dsun7c4/ntpserver-kicad/README.md

# kicad submodule of [ntpserver](https://github.com/dsun7c4/ntpserver)
