dsun7c4/ntpserver-kicad/clock/clock.csv

Reference | Value | Datasheet | Footprint | Qty | DNP | Current | Dielectric | Frequency | Manufacturer | PartNum | Power | Tolerance | Voltage
A201 | CX210_Cover |  | Local:CX210_Cover | 1 |  |  |  |  | Custom | PN
A401 | Microzed |  | Local:Microzed_RevF | 1 |  |  |  |  | Avnet | AES-Z7MB-7Z010-G
BT601 | CR2032 |  | Local:Battery_Holder_2032_BK-5058 | 1 |  |  |  |  | Memory Protection Devices | BK-5058 |  |  | 3.0V
C201,C202,C203,C204,C205,C208,C213,C214,C216,C219,C303,C401,C507,C508,C509,C510,C511,C512,C601,C602,C603 | 0.1uF |  | Local:C_0805_HandSoldering | 21 |  |  | X7R |  | Kemet | C0805C104K5RACTU |  | 10% | 50V
C206,C207,C217 | 0.1uF |  | Local:C_0805_HandSoldering | 3 | DNP |  | X7R |  | Kemet | C0805C104K5RACTU |  | 10% | 50V
C209 | 22uF |  | Local:C_1206_3216Metric_Pad2.00x1.60mm_HandSolder | 1 | DNP |  | X5R |  | TDK | C3216X5R1A226M160AC |  | 20% | 10V
C210 | 470pF |  | Local:C_0805_HandSoldering | 1 |  |  | C0G |  | Kemet | C0805C471J5GACTU |  | 5% | 50V
C211 | 10pF |  | Local:C_0805_HandSoldering | 1 |  |  | C0G |  | Kemet | C0805C100J5GACTU |  | 5% | 50V
C212,C519,C520,C521,C522,C523,C524 | 22uF |  | Local:C_1206_3216Metric_Pad2.00x1.60mm_HandSolder | 7 |  |  | X5R |  | TDK | C3216X5R1A226M160AC |  | 20% | 10V
C215,C218,C301,C302,C501,C502,C503,C504,C505,C506 | 10uF |  | Local:C_1206_3216Metric_Pad2.00x1.60mm_HandSolder | 10 |  |  | X5R |  | TDK | C3216X5R1E106K160AB |  | 10% | 25V
C402,C516,C517,C518 | 47pF |  | Local:C_0805_HandSoldering | 4 |  |  | C0G |  | Kemet | C0805C470J5GACTU |  | 5% | 50V
C513,C514,C515 | 0.47uF |  | Local:C_0805_HandSoldering | 3 |  |  | X7R |  | Kemet | C0805C474K5RACTU |  | 10% | 50V
D201,D301,D501,D502 | GREEN |  | Local:LED_0805_HandSoldering | 4 |  |  |  |  | Lite-On | LIST-C171GKT
D401 | MM3Z3V3T1G |  | Local:SOD-323_477-02-H_HandSoldering | 1 |  |  |  |  | ON Semiconductor | MM3Z3V3T1G | 300mW |  | 3.3V
FB201,FB301 | 60@100MHz | ~ | Local:R_0805_2012Metric_Pad1.50x1.30mm_HandSolder | 2 |  | 3A |  |  | Pulse Electronics | PE-0805PFB600ST |  | 25%
HS201 | TO220_heatsink |  | Local:Heatsink_581x | 1 |  |  |  |  | Aavid | 581002B02500G
JP501,JP502 | Jumper_NO_Small |  | Connector_PinHeader_2.54mm:PinHeader_1x02_P2.54mm_Vertical | 2
L501 | 3.3uH |  | Local:Choke_SMD_7.1x6.5_H3.0_HandSoldering | 1 |  | 6.2A |  |  | TDK | SPM6530T-3R3M
L502,L503 | 2.2uH |  | Local:Choke_SMD_7.1x6.5_H3.0_HandSoldering | 2 |  | 8.4A |  |  | TDK | SPM6530T-2R2M
P101 | CONN_01X03 |  | Local:Terminal_Block_1x03 | 1 |  |  |  |  | Phoenix Contact | 1729131
P102 | CONN_FAN_PWM |  | Local:470531000 | 1 |  |  |  |  | Molex | 47053-1000
P103 | XG4A-1631 |  | Local:XG4A-1631 | 1 |  |  |  |  | Omron Electronics | XG4A-1631
P301 | MCRF |  | Local:MCRF_73412 | 1 |  |  |  |  | Molex | 073412-0110
P401 | CONN_01X10 |  | Connector_PinHeader_2.54mm:PinHeader_1x10_P2.54mm_Horizontal | 1 | DNP
PX1,PX2 | 61083_02X50 |  | Local:61083-2X50-SMD_HandSoldering | 2 |  |  |  |  | FCI | 61083-101400LF
Q201 | MMBT3904 |  | Local:SOT-23-3_NXP_HandSoldering | 1 |  |  |  |  | NXP Semiconductors | MMBT3904
Q301,Q302,Q401,Q402 | BSS138 |  | Local:SOT-23-3_NXP_HandSoldering | 4 | DNP |  |  |  | ON Semiconductor | BSS138LT1G
Q501,Q502 | BSS138 |  | Local:SOT-23-3_NXP_HandSoldering | 2 |  |  |  |  | ON Semiconductor | BSS138LT1G
R201,R202,R206,R207,R211,R219,R302,R305,R406,R517,R518,R601,R602,R603,R604,R605,R606,R607,R608,R609,R610,R611,R612 | 1.00K |  | Local:R_0805_HandSoldering | 23 |  |  |  |  | Vishay Dale | CRCW08051K00FKEA | 0.125W | 1%
R203,R204,R213,R215,R216,R217,R301,R303,R401,R407,R410,R504,R505,R506,R516 | 10.0K |  | Local:R_0805_HandSoldering | 15 |  |  |  |  | Vishay Dale | CRCW080510K0FKEA | 0.125W | 1%
R205,R501,R502,R503,R513 | 100K |  | Local:R_0805_HandSoldering | 5 |  |  |  |  | Vishay Dale | CRCW0805100KFKEA | 0.125W | 1%
R208,R209,R210 | 49.9K |  | Local:R_0805_HandSoldering | 3 |  |  |  |  | Vishay Dale | CRCW080549K9FKEA | 0.125W | 1%
R212 | 0.1R |  | Local:CSM2512_0R007_0R2 | 1 |  |  |  |  | Vishay Foil | Y14870R10000B9R | 1W | 0.1%
R214,R218 | 36.5R |  | Local:R_0805_HandSoldering | 2 |  |  |  |  | Vishay Dale | CRCW080536R5FKEA | 0.125W | 1%
R304,R408 | 10.0K |  | Local:R_0805_HandSoldering | 2 | DNP |  |  |  | Vishay Dale | CRCW080510K0FKEA | 0.125W | 1%
R402,R403,R404,R405,R409,R411 | 0R |  | Local:R_0805_HandSoldering | 6 |  |  |  |  | Vishay Dale | CRCW08050000Z0EA | 0.125W | 1%
R507 | 36.5K |  | Local:R_0805_HandSoldering | 1 |  |  |  |  | Vishay Dale | CRCW080536K5FKEA | 0.125W | 1%
R508,R510,R512 | 4.99K |  | Local:R_0805_HandSoldering | 3 |  |  |  |  | Vishay Dale | CRCW08054K99FKEA | 0.125W | 1%
R509 | 22.6K |  | Local:R_0805_HandSoldering | 1 |  |  |  |  | Vishay Dale | CRCW080522K6FKEA | 0.125W | 1%
R511 | 20.0K |  | Local:R_0805_HandSoldering | 1 |  |  |  |  | Vishay Dale | CRCW080520K0FKEA | 0.125W | 1%
R514,R515 | 100K |  | Local:R_0805_HandSoldering | 2 | DNP |  |  |  | Vishay Dale | CRCW0805100KFKEA | 0.125W | 1%
U201 | PCA9306 |  | Package_SO:MSOP-8_3x3mm_P0.65mm | 1 |  |  |  |  | Texas Instruments | PCA9306DCTR
U202 | DAC8830 |  | Package_SO:SOIC-8_3.9x4.9mm_P1.27mm | 1 |  |  |  |  | Texas Instruments | DAC8830ICD |  | ± 1 LSB
U203 | LMV722 |  | Package_SO:SOIC-8_3.9x4.9mm_P1.27mm | 1 |  |  |  |  | Texas Instruments | LMV722MX/NOPB
U204 | LTC2990 |  | Package_SO:MSOP-10_3x3mm_P0.5mm | 1 |  |  |  |  | Linear Technology | LTC2990CMS#PBF
U205 | LP3853 |  | Local:TO220-5-Vertical_NDH | 1 |  | 3A |  |  | Texas Instruments | LP3853ET-3.3/NOPB |  |  | 3.3V
U207 | NC7SZ125 |  | Local:SOT-23-5_1.6x2.9mm_Pitch0.95mm_HandSoldering | 1 |  |  |  |  | Fairchild Semiconductor | NC7SZ125M5X
U301 | Adafruit746 |  | Local:Adafruit746 | 1 | DNP |  |  |  | Adafruit | Adafruit746
U302 | MIC5225 |  | Local:SOT-23-5_1.6x2.9mm_Pitch0.95mm_HandSoldering | 1 |  | 0.15A |  |  | Micrel | MIC5225-3.3YM5-TR |  |  | 3.3V
U303 | PA6H |  | Local:FGPMMOPA6H | 1 |  |  |  |  | GlobalTop Technology | PA6H
U401 | 74LVC541 |  | Package_SO:TSSOP-20_4.4x6.5mm_P0.65mm | 1 |  |  |  |  | Texas Instruments | SN74LVC541APWR
U501,U502,U503 | TPS56428 |  | Local:SOIC-8_PowerPAD_HandSoldering | 3 |  |  |  |  | Texas Instruments | TPS56428DDA
U601,U603 | ADT7410 |  | Package_SO:SOIC-8_3.9x4.9mm_P1.27mm | 2 |  |  |  |  | Analog Devices | ADT7410TRZ
U602 | DS3231 |  | Local:SOIC-16_Maxim_W16_H2 | 1 |  |  |  |  | Maxim Integrated | DS3231S#
Y202 | CX210 |  | Local:CX210_HandSoldering | 1 |  |  |  | 10.0MHz | Connor Winfield | OH300-50503CV-010.0M
