dsun7c4/ntpserver-kicad/2x7seg/disp.csv

Reference | Value | Datasheet | Footprint | Qty | DNP | Current | Dielectric | Frequency | Manufacturer | PartNum | Power | Tolerance | Voltage
C1,C3 | 10uF |  | Local:C_1206_HandSoldering | 2 |  |  | X5R |  | TDK | C3216X5R1E106K160AB |  | 10% | 25V
C2,C4 | 0.1uF |  | Local:C_0805_HandSoldering | 2 |  |  | X7R |  | Kemet | C0805C104K5RACTU |  | 10% | 50V
DS1 | LDD-A814RI |  | Local:LDD-A814RI | 1 |  |  |  |  | Lumex | LDD-A814RI
P1,P2 | CONN_01X08 |  | Local:Pin_Header_1x08_edge | 2
R1 | 5.11K |  | Local:R_0805_HandSoldering | 1 |  |  |  |  | Vishay Dale | CRCW08055K11FKEA | 0.125W | 1%
U1 | TLC59282_REV |  | Local:SSOP-24_3.9x8.65mm_Pitch0.635mm | 1 |  |  |  |  | Texas Instruments | TLC59282DBQ
