dsun7c4/ntpserver-kicad/8x16seg/8x16seg.csv

Reference | Value | Datasheet | Footprint | Qty | DNP | Dielectric | Manufacturer | PartNum | Power | Tolerance | Voltage | Current | Frequency
C1,C10,C11,C20 | 10uF |  | Local:C_1206_HandSoldering | 4 |  | X5R | TDK | C3216X5R1E106K160AB |  | 10% | 25V
C2,C3,C4,C5,C6,C7,C8,C9,C12,C13,C14,C15,C16,C17,C18,C19 | 0.1uF |  | Local:C_0805_HandSoldering | 16 |  | X7R | Kemet | C0805C104K5RACTU |  | 10% | 50V
DS1,DS2,DS3,DS4,DS5,DS6,DS7,DS8 | PSA08-11SRWA |  | Local:PSA08-11SRWA | 8 |  |  | Kingbright | PSA08-11SRWA
P1,P2 | CONN_01X08 |  | Connector_PinSocket_2.54mm:PinSocket_1x08_P2.54mm_Vertical | 2
R1,R2,R3,R4,R5,R6,R7,R8,R9 | 5.11K |  | Local:R_0805_HandSoldering | 9 |  |  | Vishay Dale | CRCW08055K11FKEA | 0.125W | 1%
U1,U2,U3,U4,U5,U6,U7,U8,U9 | TLC59282_REV |  | Local:SSOP-24_3.9x8.65mm_Pitch0.635mm | 9 |  |  | Texas Instruments | TLC59282DBQ
