dsun7c4/ntpserver-kicad/rj45brkout/rj45brkout.csv

Reference | Value | Datasheet | Footprint | Qty | DNP | Manufacturer | PartNum | Voltage | Tolerance | Dielectric | Power | Current | Frequency
J101 | RJ45_LEDS |  | Local:rj45-8-pm | 1 |  | Amphenol | MRJ5381M1
P101,P102,P103,P104,P105,P106,P107,P108,P109,P110,P111,P112 | CONN_01X01 |  | Local:wire_50x30mil | 12
