dsun7c4/ntpserver-kicad/8x16seg/8x16seg.pdf

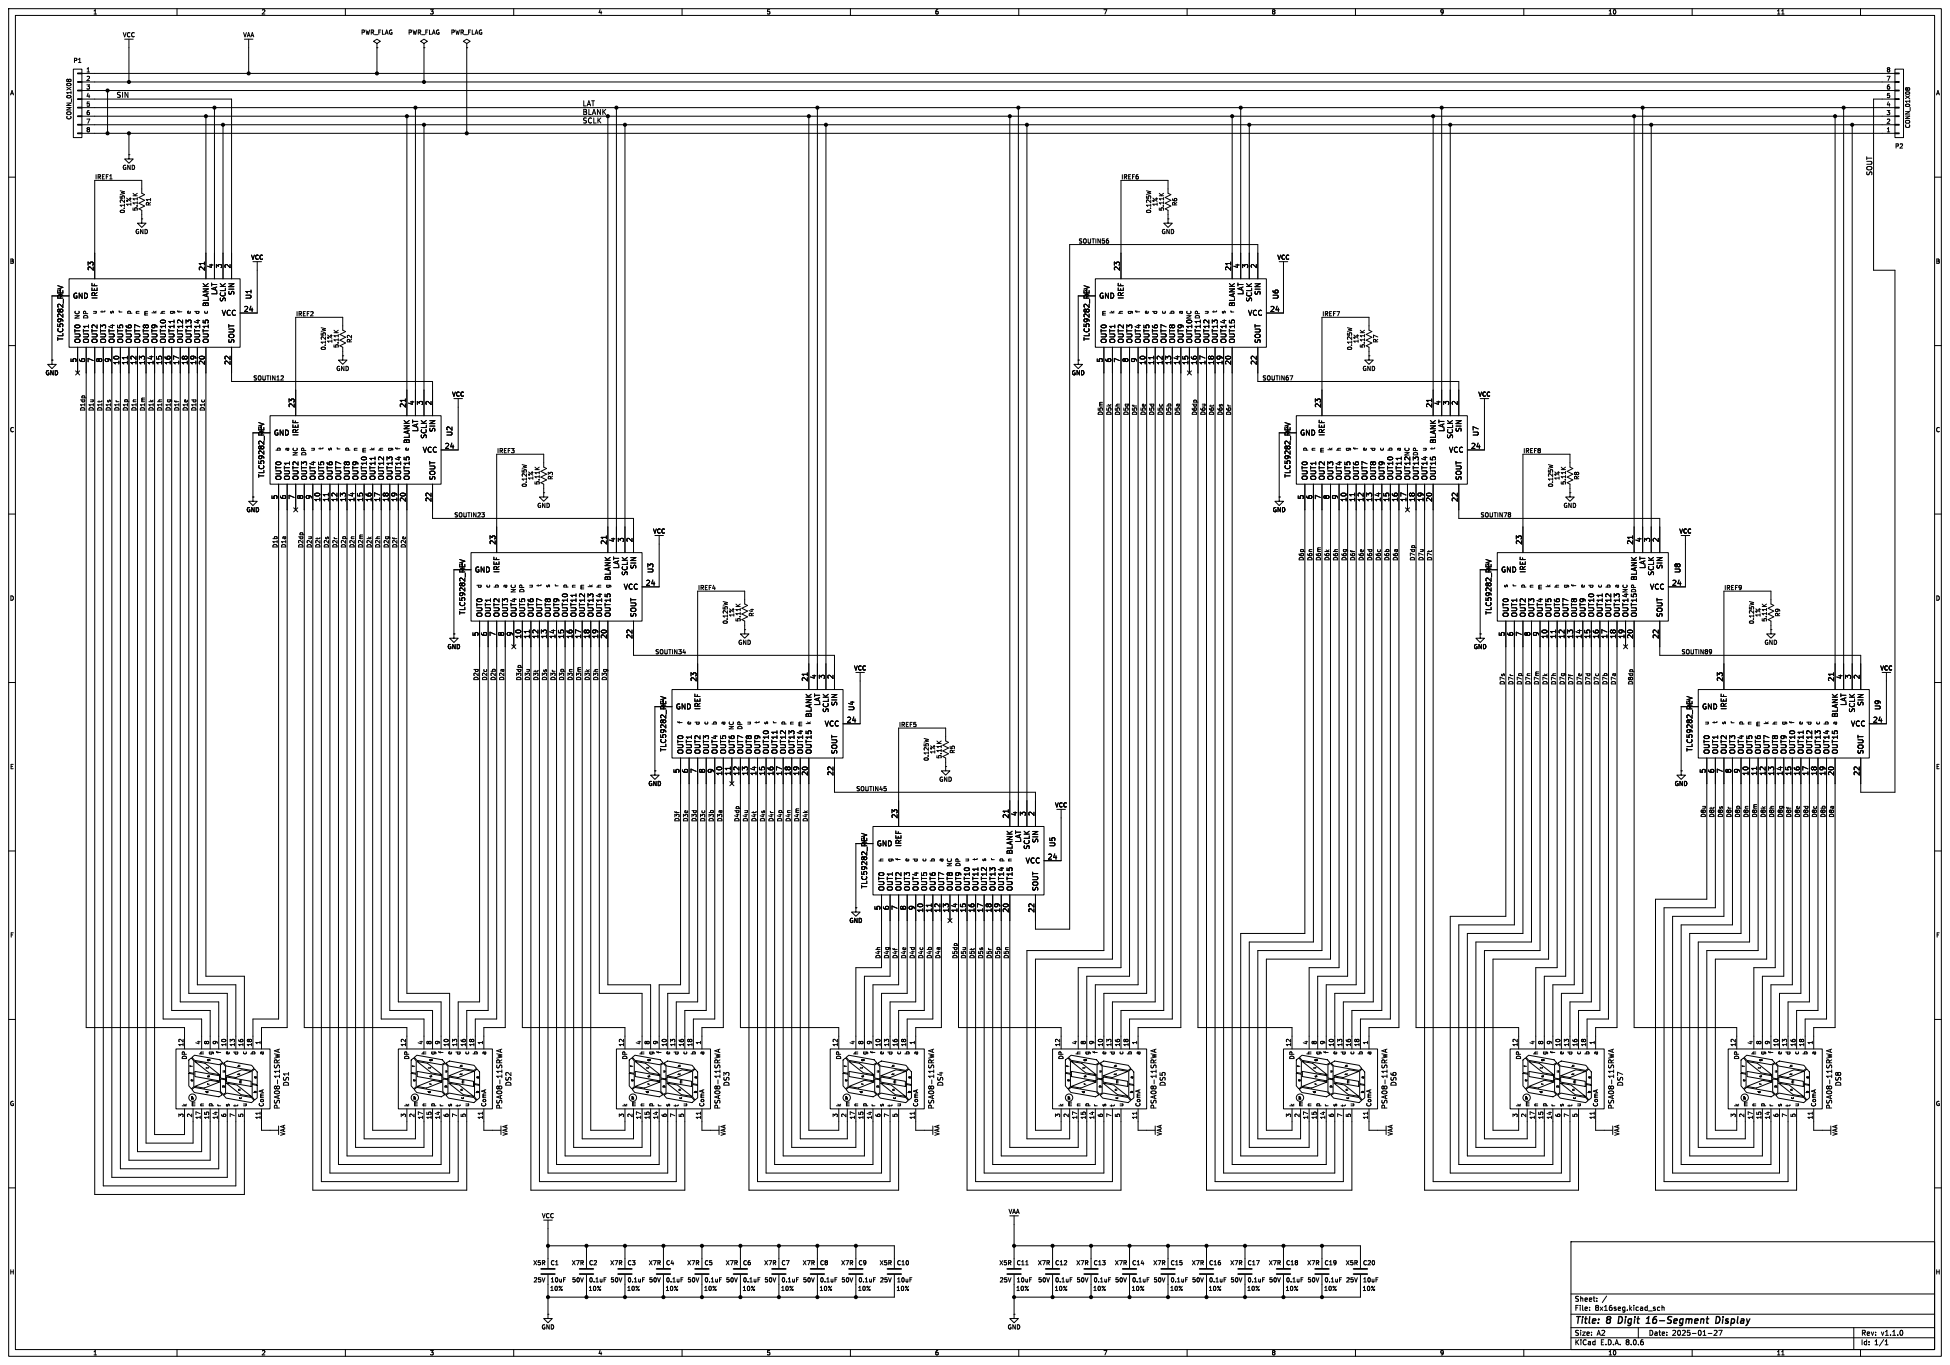
[picture p1: page 1]

2 OUT15 20 BLANK 21 SOUT 22 IREF 23 SCLK

r GND GND GND U4 TLC59282_REVGND 1 VCC 24 OUT5 10 OUT6 11 OUT7 12 OUT8 13 OUT9 14 OUT10 15 OUT11 16 OUT12 17 OUT13 18 OUT14 19 SIN
