dsun7c4/ntpserver-kicad/clock/clock.pdf

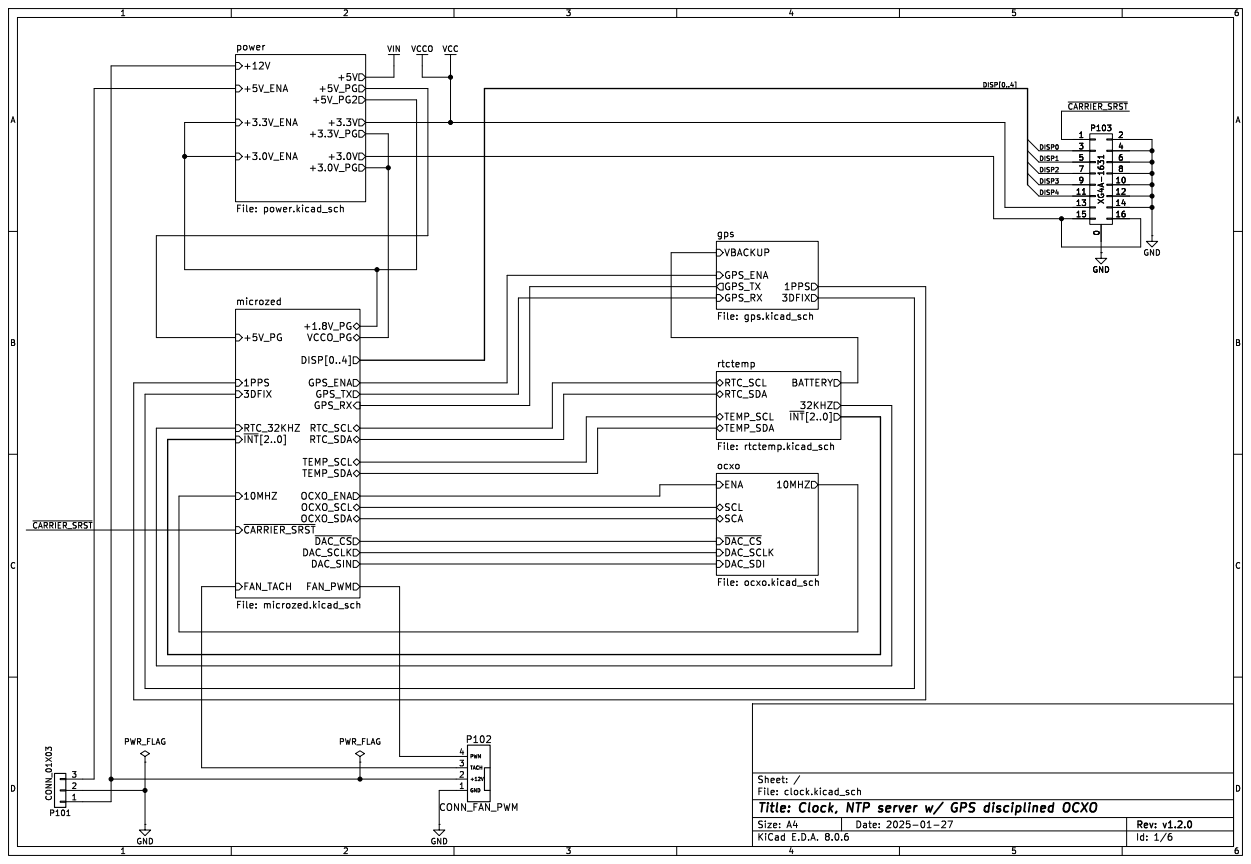
[picture p2: page 1]

~{INT}[2..0] microzed File: microzed.kicad_sch

gps File: gps.kicad_sch
VBACKUP
File: clock.kicad_sch Sheet: / 10MHZ SCL

Id: 1/6 Title: Clock, NTP server w/ GPS disciplined OCXO

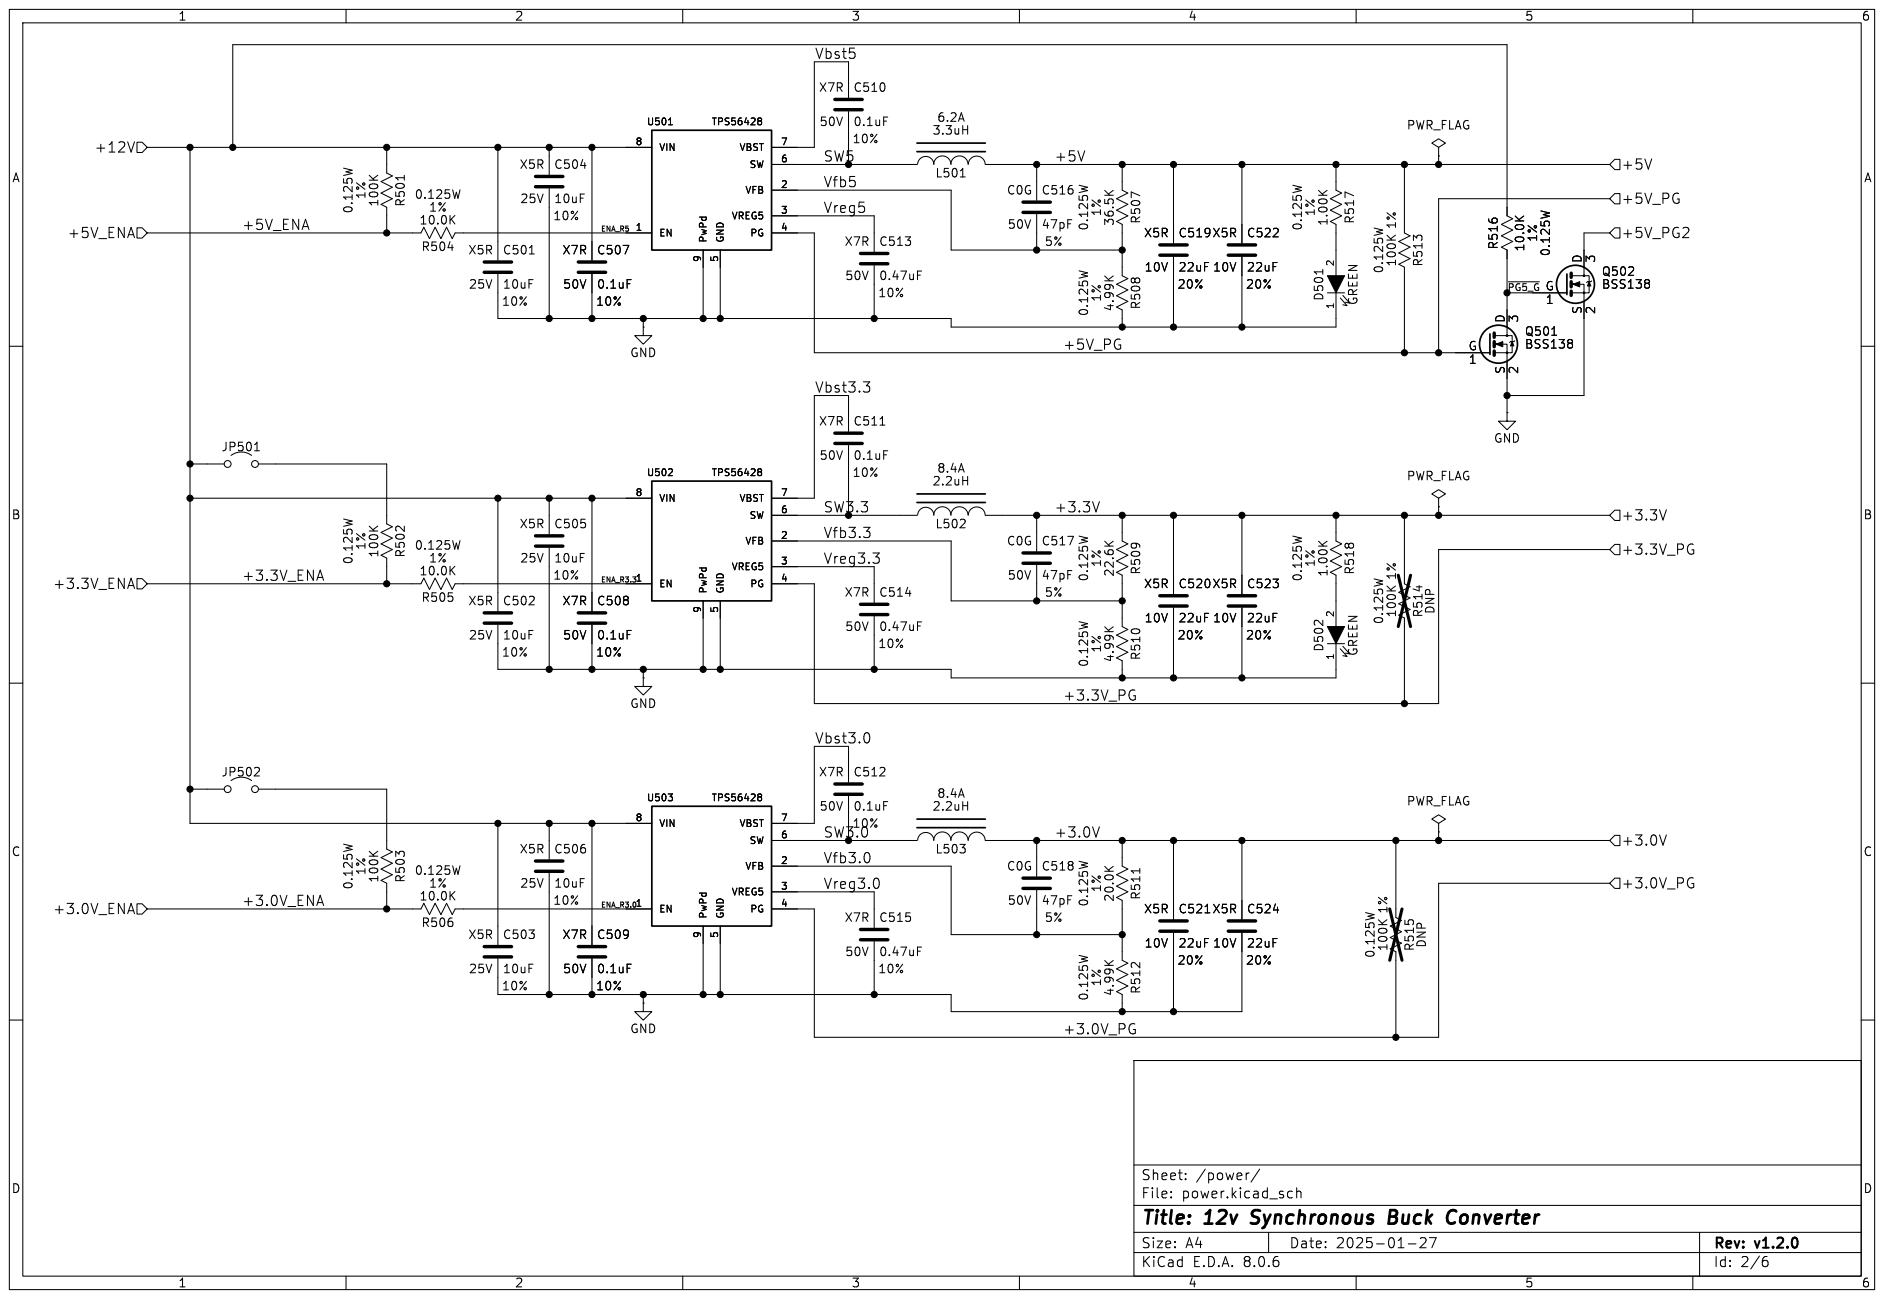
[picture p3: page 2]

5 SW 6 VBST 7 VIN 8 PwPd

9 U502 TPS56428 EN 1 VFB 2 VREG5 3 PG 4 GND

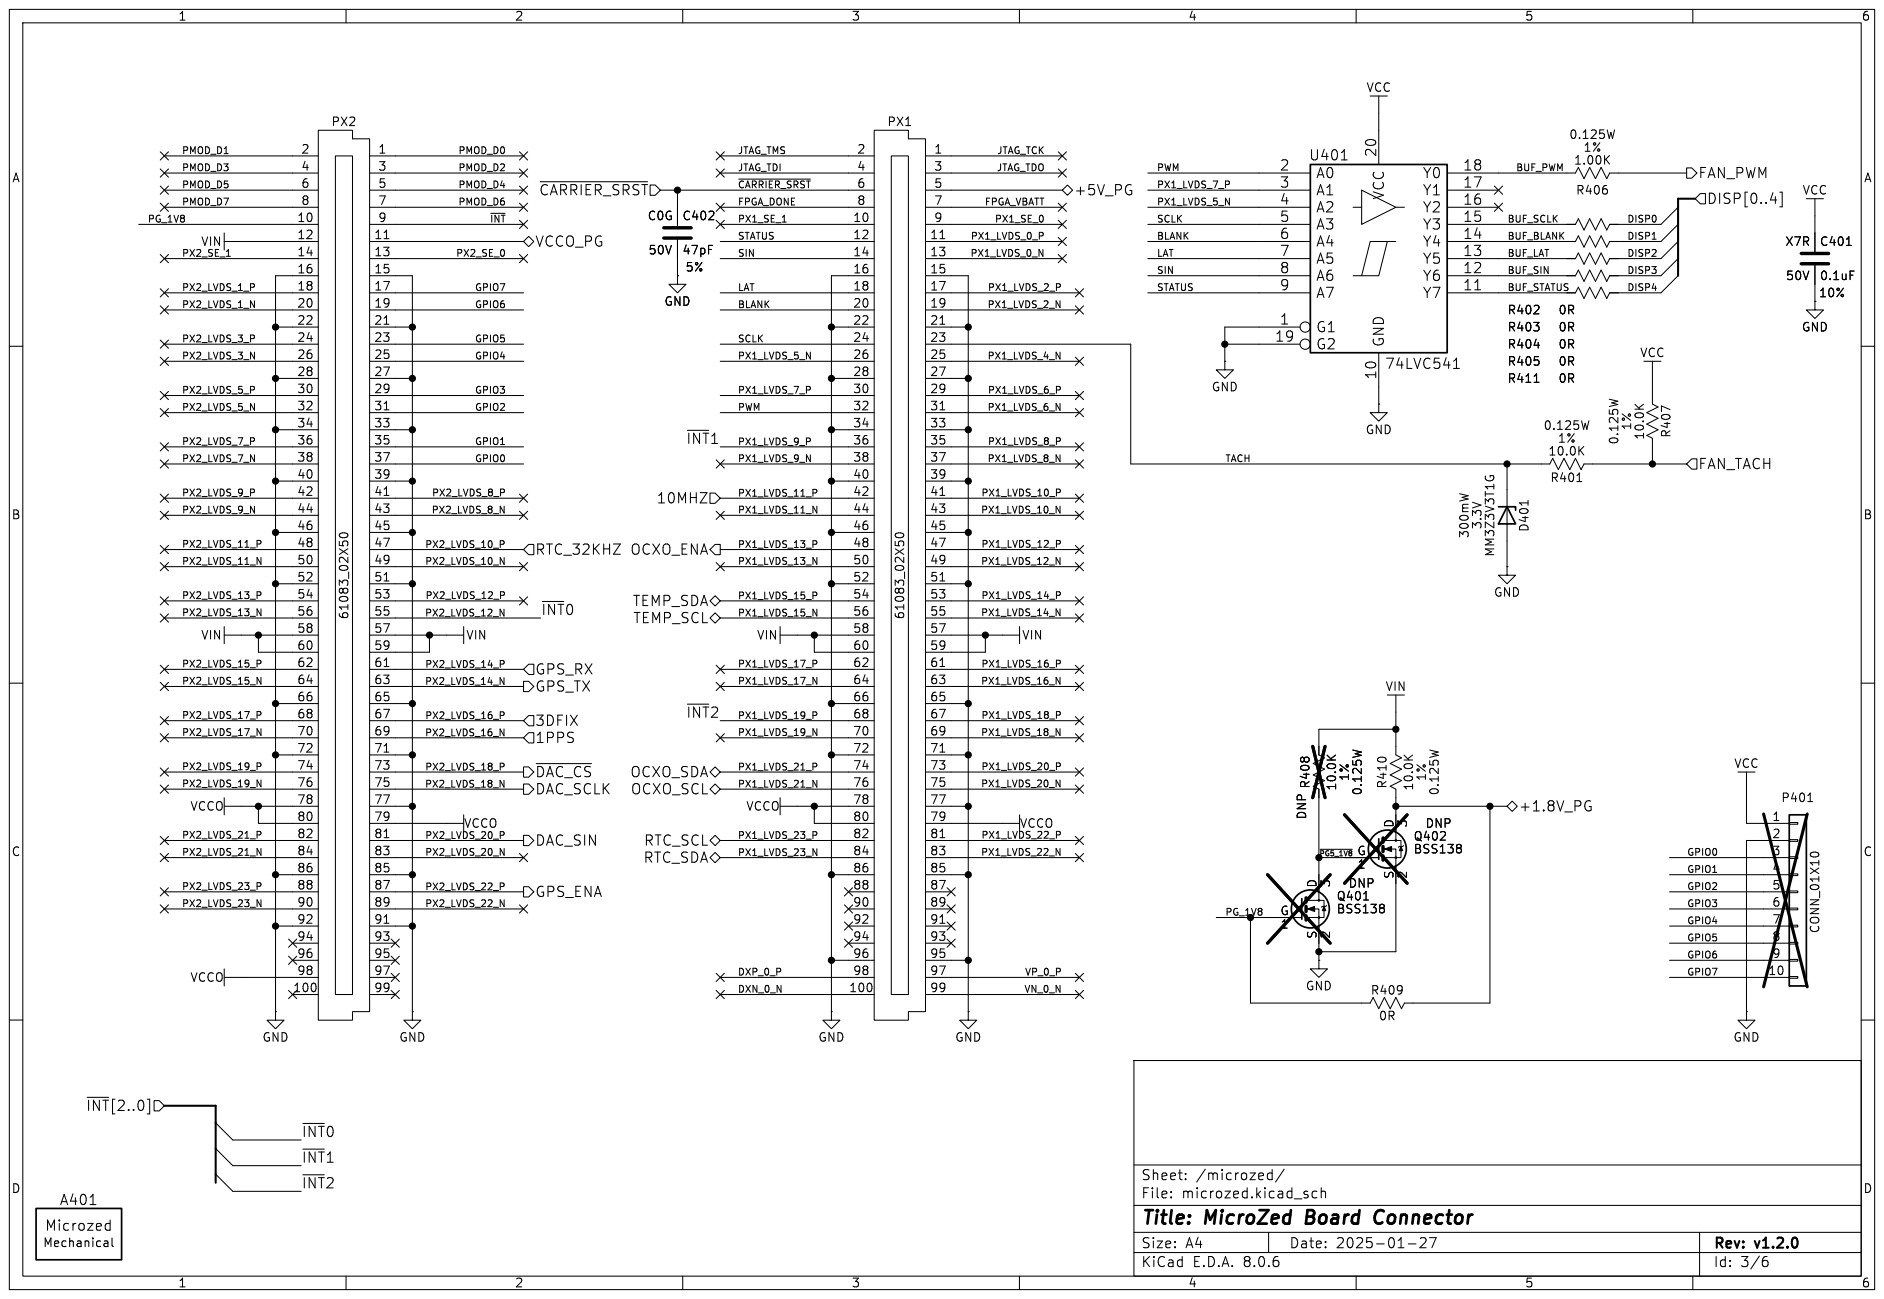
[picture p4: page 3]

Id: 3/6 Title: MicroZed Board Connector File: microzed.kicad_sch Sheet: /microzed/ VCCO

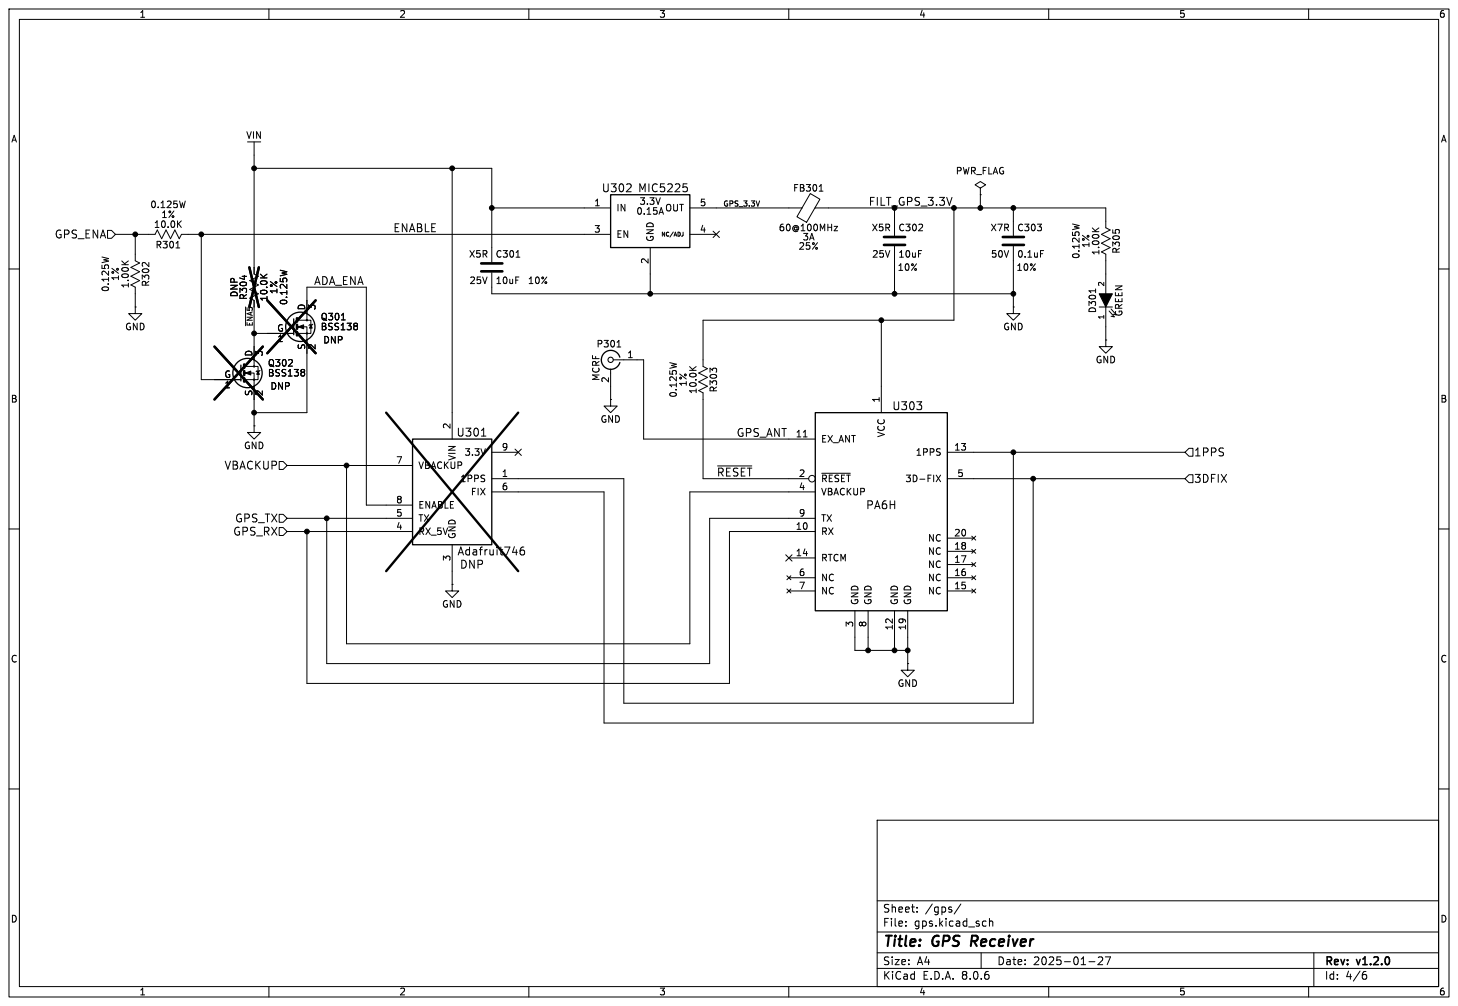
[picture p5: page 4]

3 RX_5V 4 TX 5 FIX 6 VBACKUP 7 ENABLE 8

Id: 4/6 Title: GPS Receiver File: gps.kicad_sch Sheet: /gps/

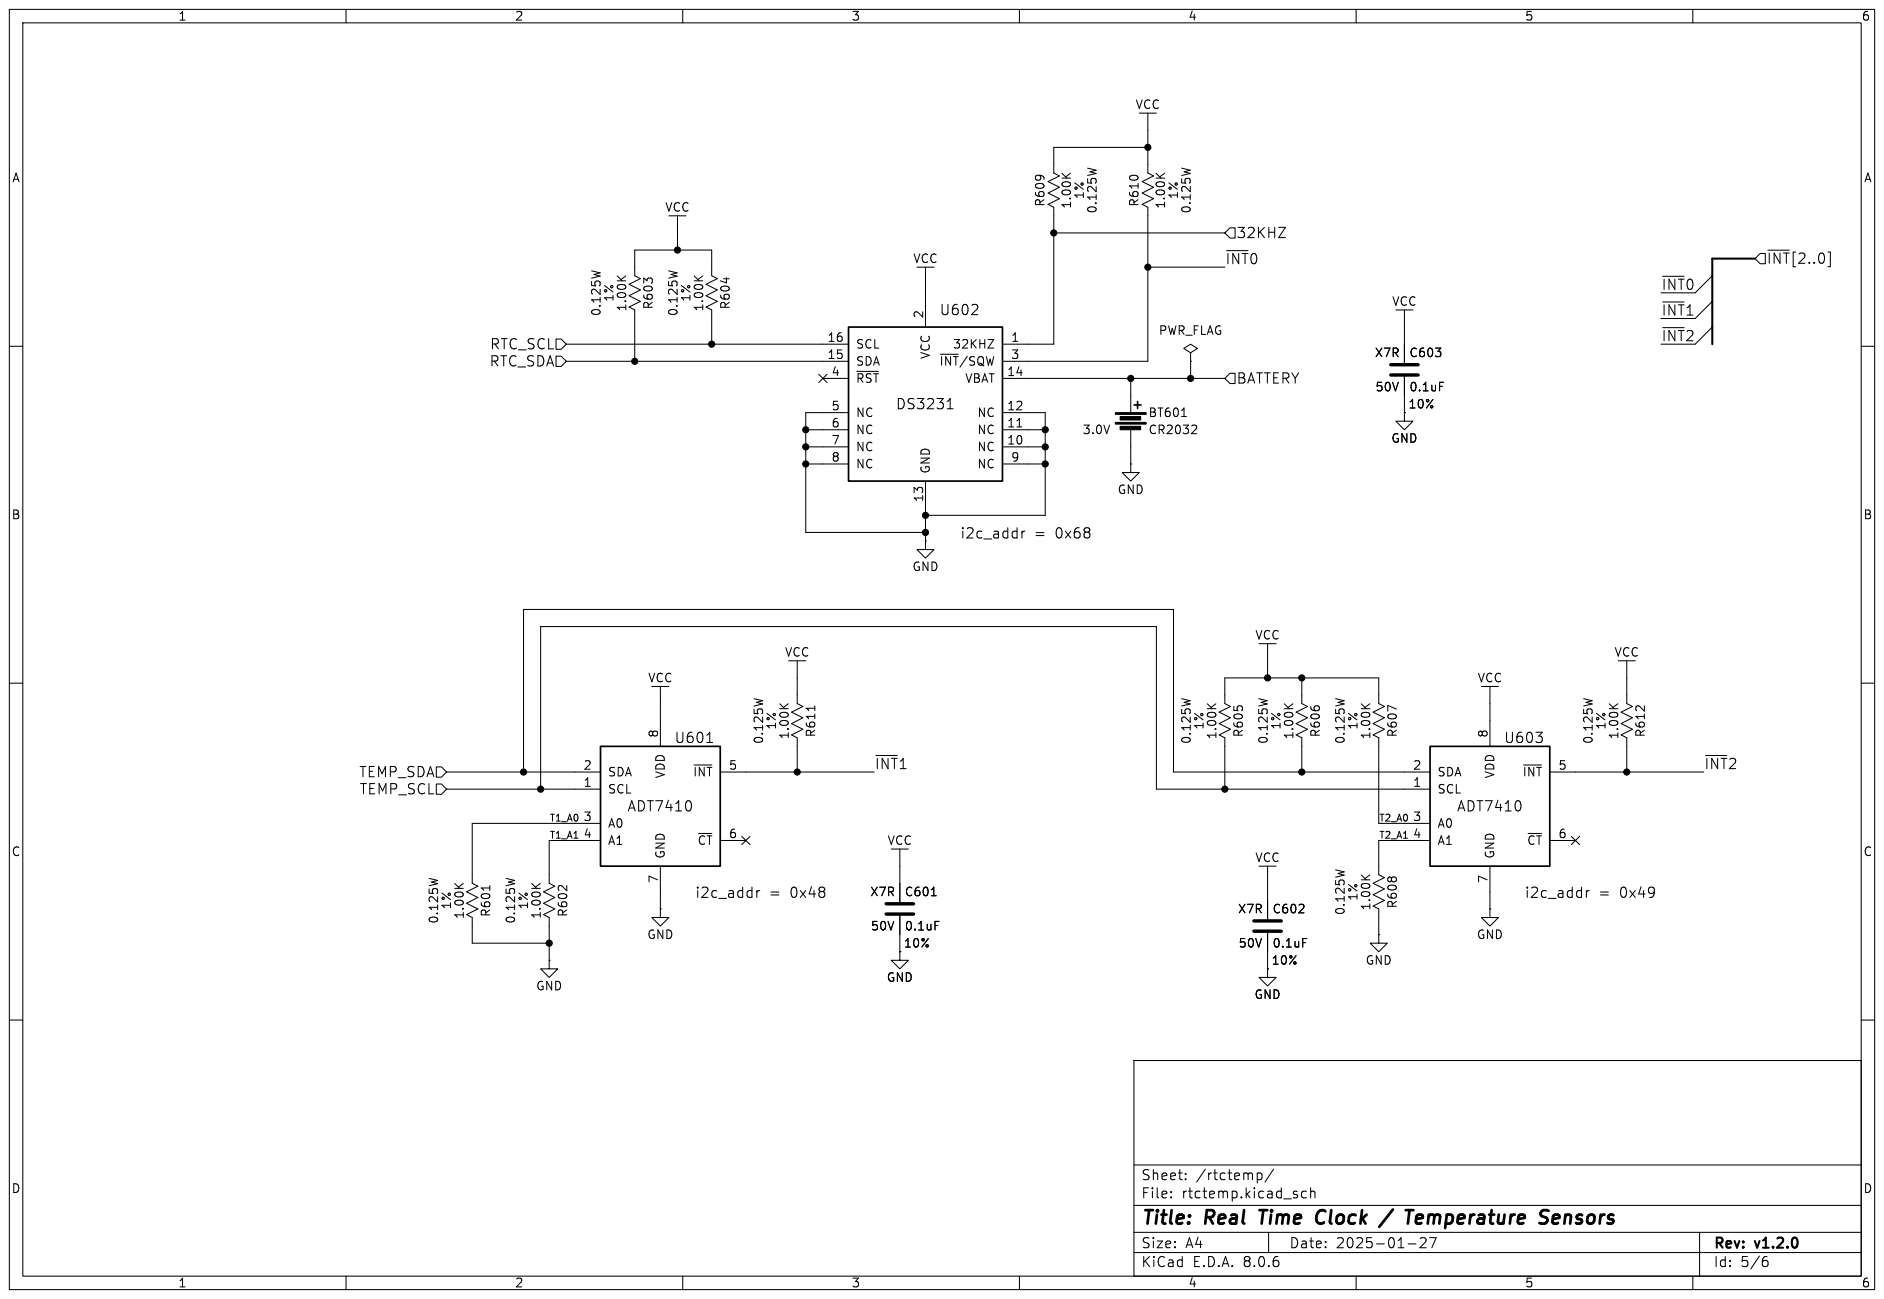
[picture p6: page 5]

2 ~{INT}/SQW 3 ~{RST} 4 NC 5 NC 6 NC 7 NC 8 NC 9 U602 DS3231

File: rtctemp.kicad_sch Sheet: /rtctemp/
Id: 5/6 Title: Real Time Clock / Temperature Sensors

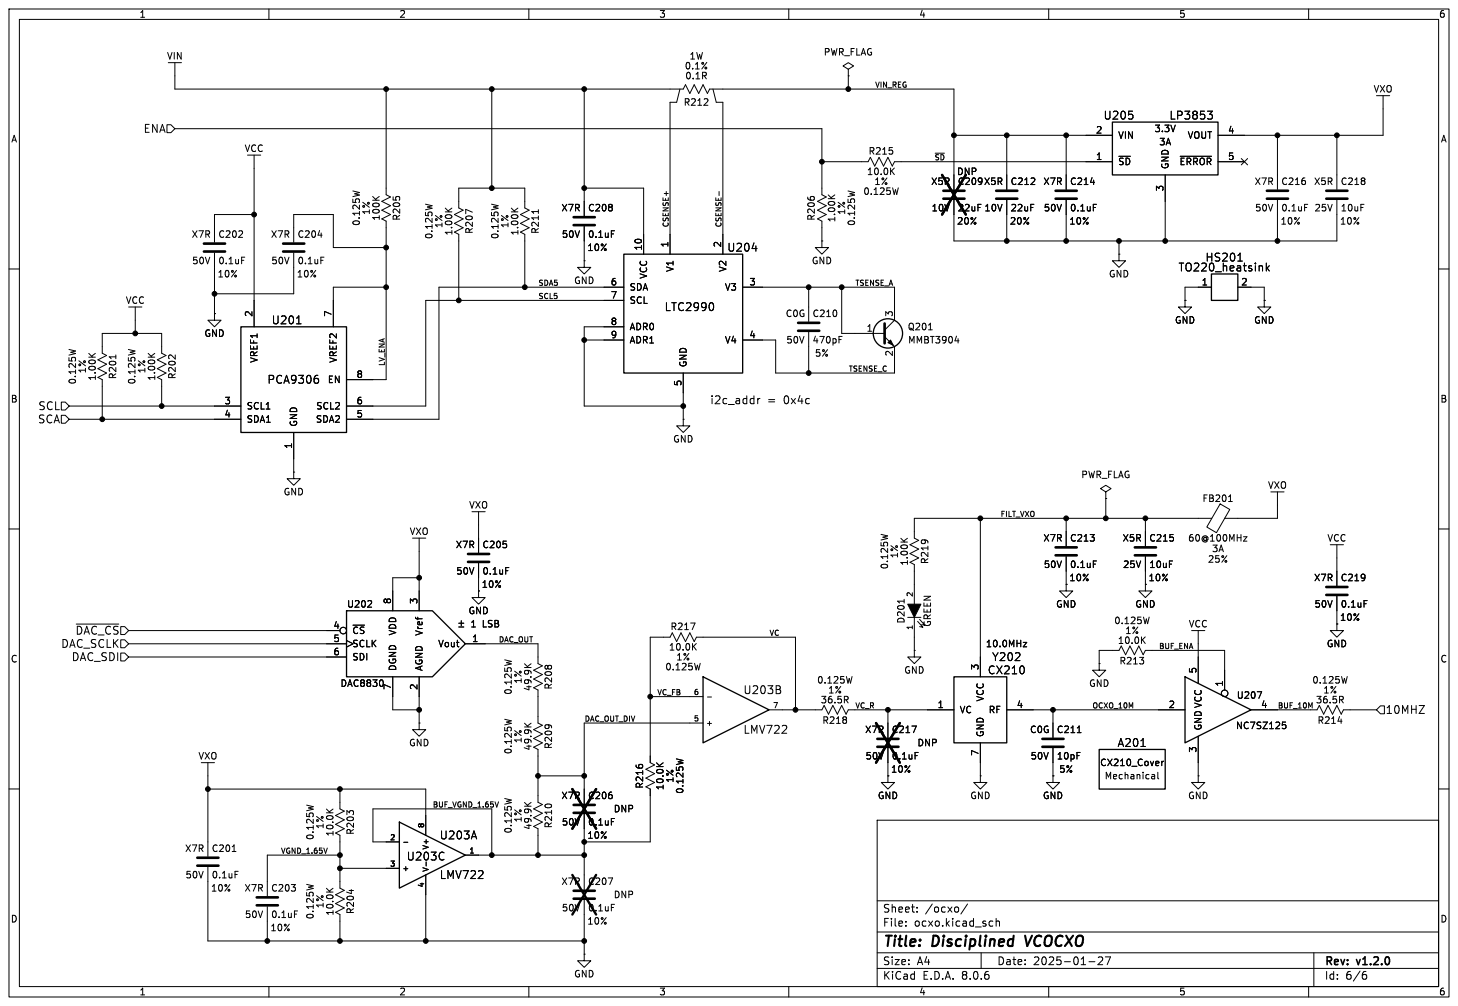
[picture p7: page 6]

2 Vref 3 ~{CS} 4 SCLK 5 SDI 6 DGND

Id: 6/6 Title: Disciplined VCOCXO
