dsun7c4/ntpserver-kicad/rj45brkout/rj45brkout.pdf

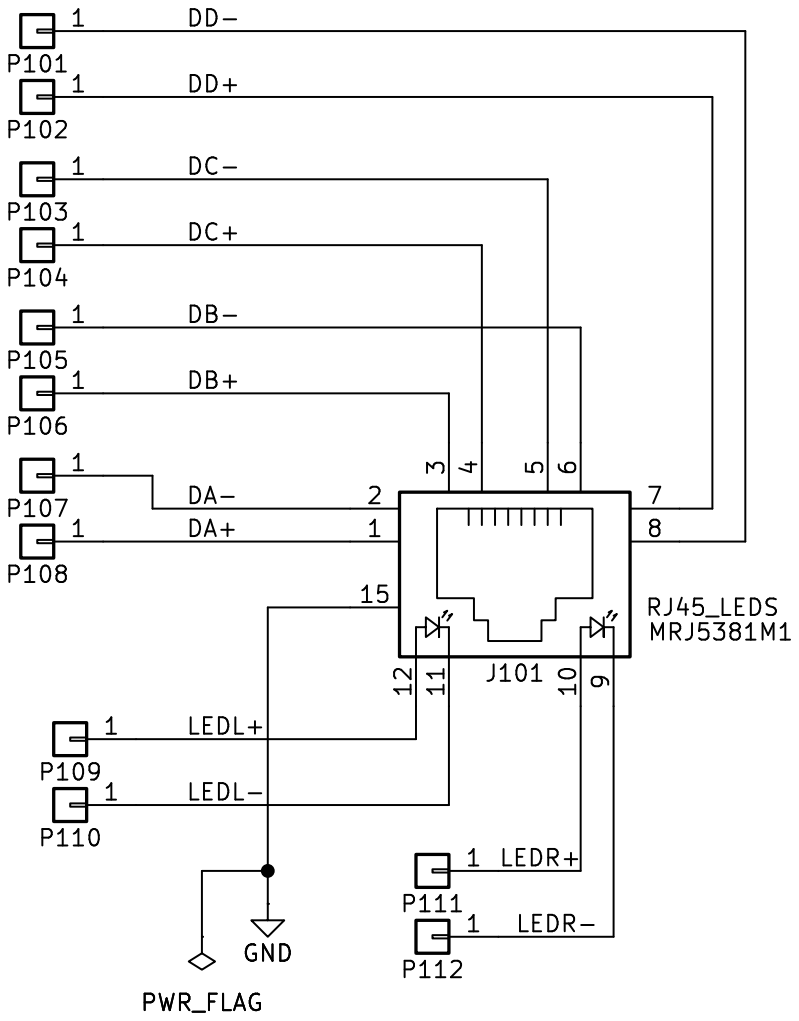
[picture p8: page 1]

LEDL- DB- DA+ DA- DD+ DD- DC- GND

Id: 1/1 Title: rj45 panel mount breakout File: rj45brkout.kicad_sch Sheet: /
