dsun7c4/ntpserver-kicad/term/term.pdf

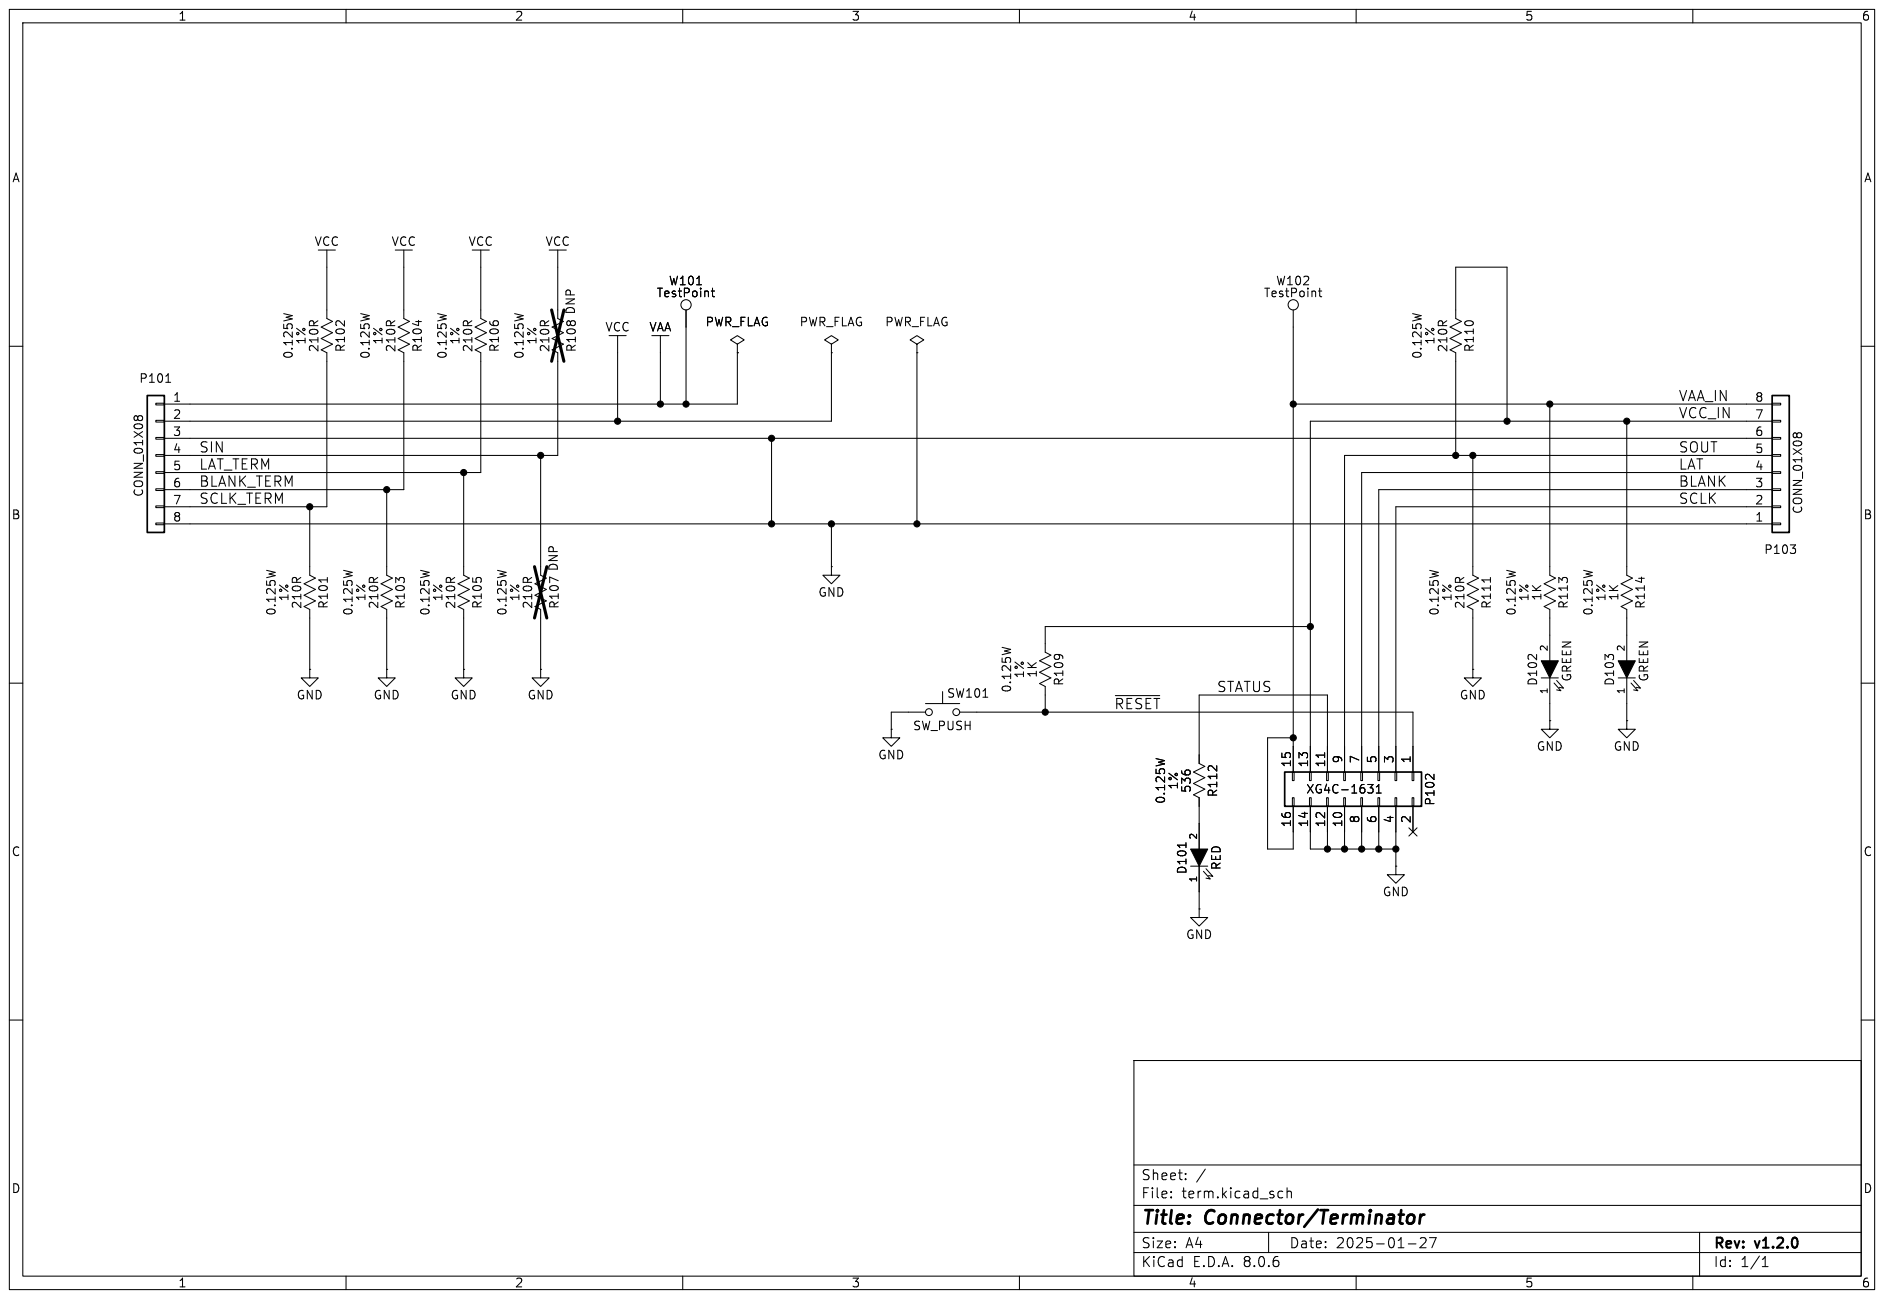
[picture p9: page 1]

1 2 D101 RED GND GND GND GND 210R R103 1% 0.125W

Id: 1/1 Title: Connector/Terminator File: term.kicad_sch Sheet: /
