dsun7c4/ntpserver-kicad/usbabrkout/usbabrkout.pdf

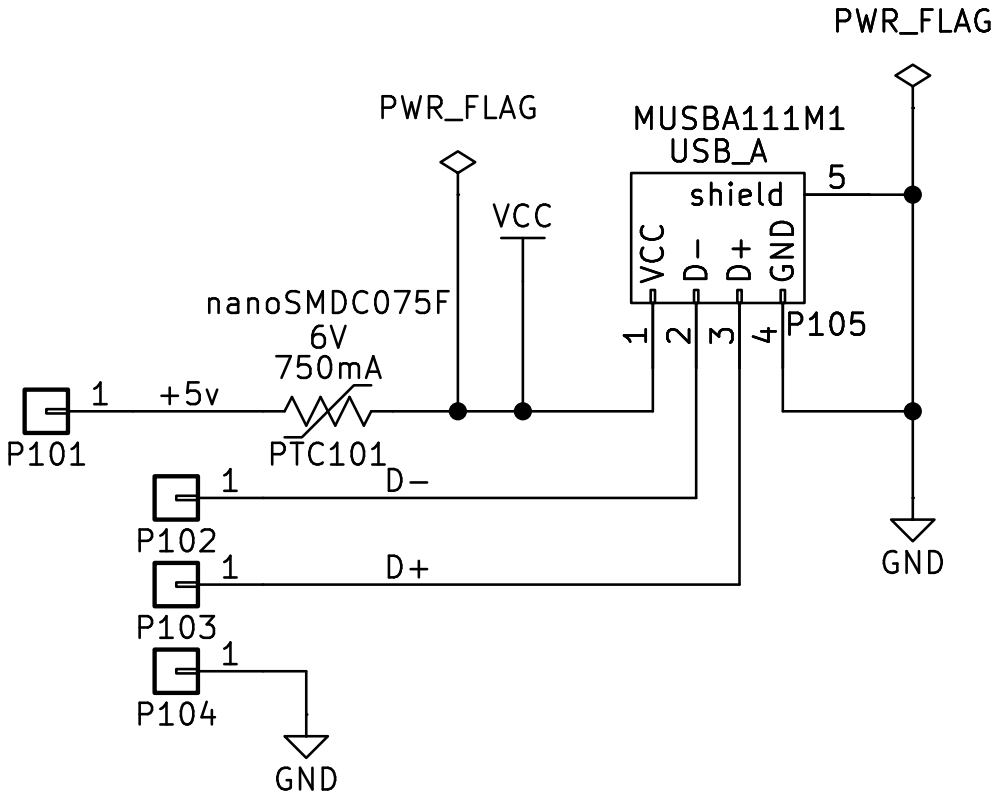
[picture p10: page 1]

3 GND
Id: 1/1 Title: USB-A panel mount breakout File: usbabrkout.kicad_sch Sheet: / VCC
