dsun7c4/ntpserver-kicad/usbbbrkout/usbbbrkout.pdf

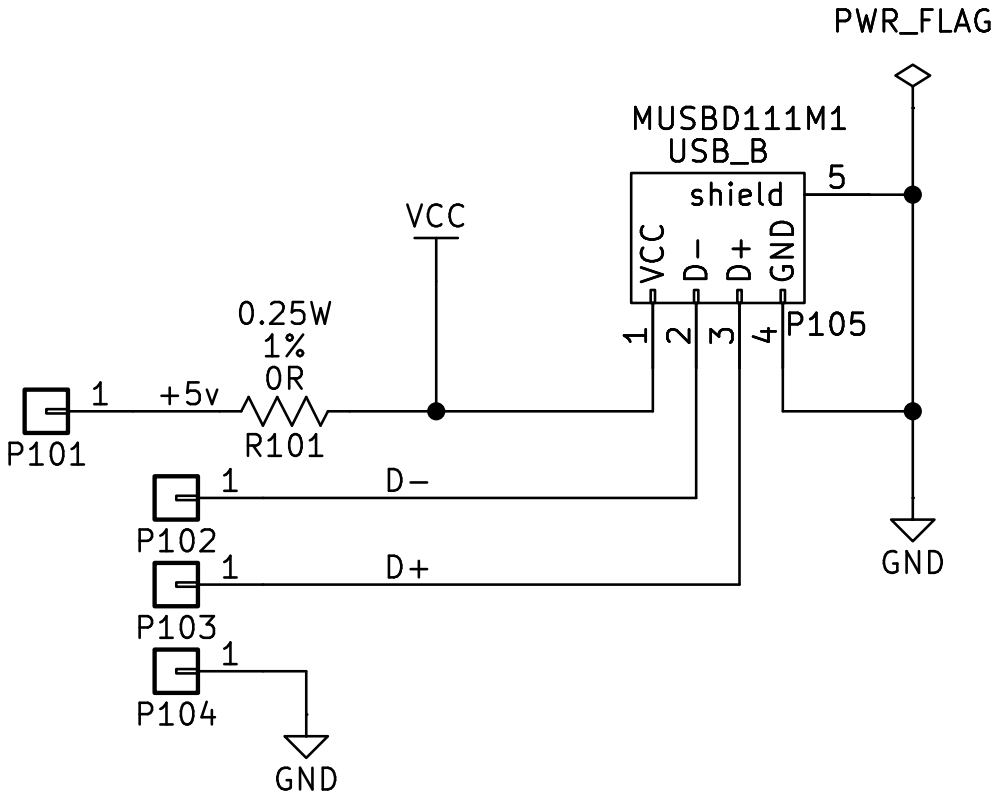
[picture p11: page 1]

Id: 1/1 Title: USB-B panel mount breakout File: usbbbrkout.kicad_sch Sheet: / R101
