dsun7c4/ntpserver-kicad/2x7seg/disp.pdf

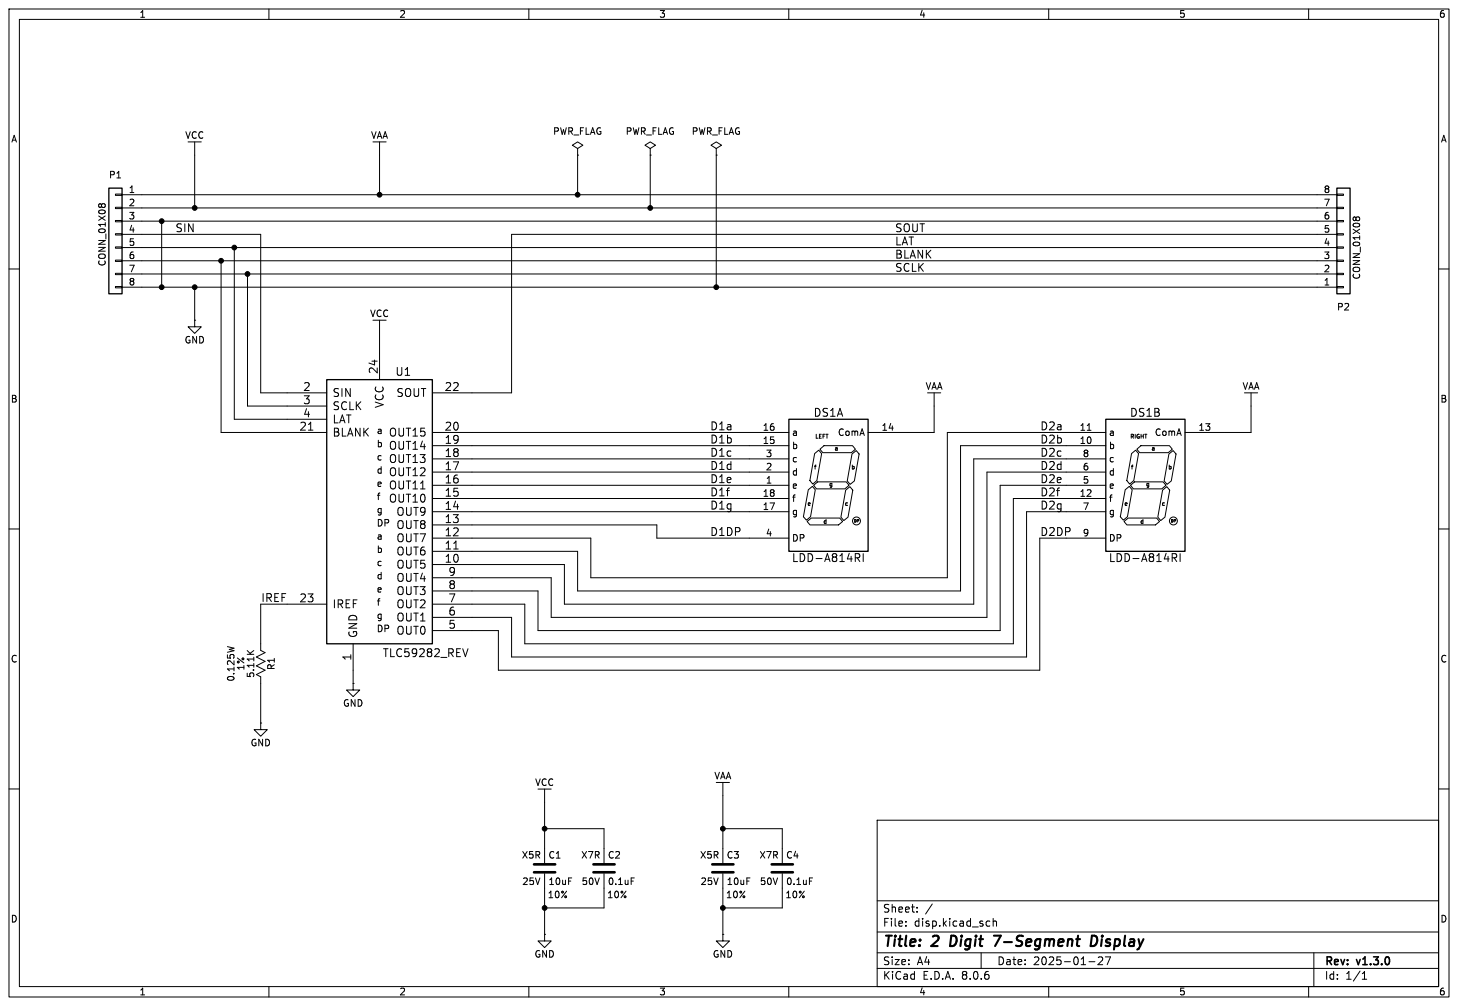
[picture p12: page 1]
