dsun7c4/ntpserver-kicad/(commit log)

2014-12-15 Add kicad local libraries
2014-12-16 Turn off some 3D models Check in gerber files Ordered...
2015-06-20 Checkpoint DCDC converter evaluation board.
2015-06-22 Fix up thermal via footprint to work with OSHPark.
2015-06-24 Fix pad position for inductor (1mm too wide). Regenerate gerbers. Upload to OSHPark.
2015-06-24 Add connector for microzed board.
2015-06-25 Add mounting hole using NPTH pad type.
2015-06-26 Add footprint for Lumex 7-segment display. Add footprint for LED current driver chip, SOIC-24.
2015-06-26 Minor local library footprint cleanup.
2015-06-29 Clean up 7-segment footprint drawing.
2015-06-30 Correct segment vertex point calculations. Regenerate footprint.
2015-07-04 Add 7-segment schematic symbol and TLC59282 driver chip.
2015-07-05 Fix pin type for TLC59282 pin 18 (OUT13). Set scale to 0.5 for 3d model of 25mil pitch SOIC24.
2015-07-05 Start 2 digit 7-segment display board.
    [disp.kicad_pcb, disp.sch]
2015-07-05 Adjust the pin drill size for the 7-seg display.
    [disp.kicad_pcb, disp.sch]
2015-07-07 Optimize some of the ground fill.
    [disp.kicad_pcb]
2015-07-08 Add pin header with edge connect footprint.
2015-07-10 Fix minimum annular ring. Use 10mil minimum clearance.
    [disp.kicad_pcb]
2015-07-12 Increase spacing between power tracks. Add gerber files.
    [disp-B_Cu.gbr, disp-B_Mask.gbr, disp-B_SilkS.gbr, disp-Edge_Cuts.gbr, disp-F_Cu.gbr, disp-F_Mask.gbr, disp-F_SilkS.gbr, disp.drl]
2015-07-17 Increase annular ring around vias.
    [disp-B_Cu.gbr, disp-B_Mask.gbr, disp-B_SilkS.gbr, disp-Edge_Cuts.gbr, disp-F_Cu.gbr, disp-F_Mask.gbr, disp-F_SilkS.gbr, disp.drl]
2015-07-18 Adjust the silk screen a little. Move some vias out of back silkscreen. Stitch in some more ground fill. Upload to OSHPark.
    [disp-B_Cu.gbr, disp-B_Mask.gbr, disp-B_SilkS.gbr, disp-Edge_Cuts.gbr, disp-F_Cu.gbr, disp-F_Mask.gbr, disp-F_SilkS.gbr, disp.drl]
2015-08-03 Use 1% resistor values
    [disp.sch]
2015-08-10 Checkpoint schematic symbol for 2x50 connector.
2015-08-16 Move some vias away from silkscreen.
    [disp-B_Cu.gbr, disp-B_Mask.gbr, disp-B_SilkS.gbr, disp-Edge_Cuts.gbr, disp-F_Cu.gbr, disp-F_Mask.gbr, disp-F_SilkS.gbr, disp.drl]
2015-09-21 Remove silk from through hole pads.
2015-09-25 Update gerber and upload to OSHPark.
    [disp-B_Cu.gbr, disp-B_Mask.gbr, disp-B_SilkS.gbr, disp-Edge_Cuts.gbr, disp-F_Cu.gbr, disp-F_Mask.gbr, disp-F_SilkS.gbr, disp.drl]
2015-10-01 Add Ad5662, ADT7410, DS3231, LTC2990, NE5532, Resistor, and cx210 schematic symbols.
2015-10-06 Add GPS receiver, VCXO, LP3853, MIC5225 and PCA9306 schematic symbols.
2015-10-17 Add footprint for CX210 and adafruit GPS module. Add DAC8830 and LVM722. Increase hole size for LDD-A814RI.
2015-10-18 Add footprint for VCXO, GTop GPS module.
2015-10-20 Initial schematic for NTP server.
    [clock.sch, gps.sch, microzed.sch, ocxo.sch, power.sch]
2015-10-20 Add power symbols.
2015-10-28 Add more BOM parameters to local parts.
2015-10-28 Fill in some of the BOM entries.
    [clock.sch, gps.sch, ocxo.sch, power.sch]
2015-10-29 Add current sense resistors.
2015-10-29 Update parts with parameter detail and BOM information.
    [gps.sch, microzed.sch, ocxo.sch, power.sch]
2015-10-30 Add heatsink and RF coax connector footprint.
2015-10-30 Add parameter for RF connector. Start adding display connections.
    [clock.sch, gps.sch, ocxo.sch, power.sch]
2015-11-01 Add schematic symbol for TO-220 heatsink. Add TO-220 footprint. Add Microzed mechanical footprint.
2015-11-01 Add sheet for RTC and temperature sensors.
    [clock.sch, gps.sch, microzed.sch, ocxo.sch, power.sch, rtctemp.sch]
2015-11-02 Add some markers in the Microzed mechanical footprint. Add single gate buffer.
2015-11-02 Add proper loading and buffer to the OCXO output.
    [clock.sch, ocxo.sch, rtctemp.sch]
2015-11-07 Add PWM fan connector.
2015-11-07 Fan and power connectors.
    [clock.sch, microzed.sch, ocxo.sch, power.sch, rtctemp.sch]
2015-11-07 Add footprint for Maxim RTC.
2015-11-08 Add SOT-23-5 footprint. Add more detail to microzed mechanical footprint.
2015-11-08 Correct footprint selection. Start pcb. Add BOM files.
    [clock.csv, clock.kicad_pcb, clock.sch, gps.sch, microzed.sch, ocxo.sch, power.sch, rtctemp.sch]
2015-11-08 Make component parameters consistent for BOM.
    [clock.csv, clock.kicad_pcb, gps.sch, ocxo.sch, power.sch, rtctemp.sch]
2015-11-09 Add net names to most of the nets.
    [clock.csv, clock.kicad_pcb, gps.sch, microzed.sch, ocxo.sch, power.sch, rtctemp.sch]
2015-11-10 Add filter for OCXO power.
    [clock.csv, clock.kicad_pcb, gps.sch, microzed.sch, ocxo.sch, power.sch, rtctemp.sch]
2015-11-12 Add OCXO cover mechanical footprint. Add CR2032 battery holder.
2015-11-12 Clean up most of the schematic DRC errors. Update placement.
    [clock.csv, clock.kicad_pcb, gps.sch, microzed.sch, ocxo.sch, power.sch, rtctemp.sch]
2015-11-14 Checkpoint PCB placement.
    [clock.csv, clock.kicad_pcb, clock.sch, ocxo.sch, power.sch, rtctemp.sch]
2015-11-15 Add On semi SOD-323 footprint. Add keepout comments to CX210 cover and adafruit 746 footprints.
2015-11-16 Rename CUS520 footprint.
2015-11-16 Checkpoint PCB.
    [clock.csv, clock.kicad_pcb, clock.sch, microzed.sch]
2015-11-20 Checkpoint... Pin swaps on microzed connector.
    [clock.kicad_pcb, gps.sch, microzed.sch]
2015-11-20 Place the reference designators.
    [clock.kicad_pcb, clock.sch, microzed.sch]
2015-11-22 Add more via stitching on the GND fills. Add gerber files.
    [clock-B_Cu.gbr, clock-B_Mask.gbr, clock-B_SilkS.gbr, clock-Edge_Cuts.gbr, clock-F_Cu.gbr, clock-F_Fab.gbr, clock-F_Mask.gbr, clock-F_SilkS.gbr]
2015-11-22 Add stitching via footprint.
2015-11-25 Correct spelling. Minor clean ups.
    [clock-B_Cu.gbr, clock-B_Mask.gbr, clock-B_SilkS.gbr, clock-Edge_Cuts.gbr, clock-F_Cu.gbr, clock-F_Fab.gbr, clock-F_Mask.gbr, clock-F_SilkS.gbr]
2015-11-26 Add NXP SOT-23 recommended footprint.
2015-11-27 Change SOT-23 footprint. Move some vias onto grid.
    [clock.csv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]
2015-11-27 Add 16 pin 8x2 header connector.
2015-11-28 Move some vias onto grid.
    [clock.kicad_pcb]
2015-11-28 Next version of display board. Increase size of holes for display pins.
    [disp.csv, disp.kicad_pcb, disp.sch]
2015-11-28 Set value to be invisible. Add large stitching via / heatsink vent hole.
2015-11-30 Hide value in stitching via. Reduce width of display board by 10 mils.
    [clock.kicad_pcb, disp.kicad_pcb]
2015-12-10 Add breakout footprint for FVXO to CX210. Add connector symbol to tie mounting holes to ground.
2015-12-10 Lock all the stitching vias. Remove FVXO alternate to OCXO.
    [clock.csv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]
2015-12-15 Rename gerbers for kicad 4.0.
    [clock-B.Cu.gbr, clock-B.Mask.gbr, clock-B.SilkS.gbr, clock-Edge.Cuts.gbr, clock-F.Cu.gbr, clock-F.Mask.gbr, clock-F.SilkS.gbr, clock.drl]
2015-12-20 Fix pad location for to-220-5. Increase hole size slightly for heatsink. Add 3D models.
2015-12-20 3D models for to220-5, cx210, heatsink.
2015-12-21 Fix pin location on to-220 and heatsink location. Add 7-segment display 3D model to board.
    [clock.kicad_pcb, disp.kicad_pcb]
2016-01-07 3D model of clock case and zync heat sink clamp.
2016-01-11 Add inductor and sot-23 3d models.
    [clock.kicad_pcb]
2016-01-11 Add 3d model of PWM fan connector.
2016-01-11 Chamfer the pin holes.
2016-01-14 Add 3D model for 100 pin FCI connector, Phoenix terminal block and RF connector.
2016-01-14 Checkpoint pin swaps and addition of 3D models.
    [clock.kicad_pcb, microzed.sch]
2016-01-16 Current shunt 3D model.
2016-01-16 Add expansion connector, 8 GPIO pins and power.
    [clock.csv, clock.kicad_pcb, microzed.sch, power.sch, rtctemp.sch]
2016-01-21 Turn off silk on through hole pins.
2016-01-22 Turn off silk on pad.
    [clock.kicad_pcb]
2016-01-23 More clean up...
    [clock.kicad_pcb]
2016-02-03 Minor clean up. Regenerate gerbers.
    [clock-B.Cu.gbr, clock-B.Mask.gbr, clock-B.SilkS.gbr, clock-Edge.Cuts.gbr, clock-F.Cu.gbr, clock-F.Mask.gbr, clock-F.SilkS.gbr, clock.drl]
2016-05-15 Generate PDF schematics.
    [clock.kicad_pcb, disp.kicad_pcb, disp.sch]
2016-06-02 Turn off silk on through hole pads.
2016-06-07 Footprints for connector and termination board.
2016-06-07 Termination and connector board.
    [term.csv, term.kicad_pcb, term.sch]
2016-06-07 Add second capacitor to 3V LDO input. Add series resistor to LDO enable.
    [clock.csv, clock.kicad_pcb, clock.sch, ocxo.sch]
2016-06-17 3D models for battery holder and ribbon cable connector. Adjust drill size slightly.
2016-06-18 Add 3D model for tactile switch and connector.
2016-06-22 Update 3d models for connectors.
2016-06-25 3D model for GPS receiver. Adjust annular ring for XG4 connectors.
2016-06-26 Add wire pads for display power. Generate gerbers for termination board. Upload to OSHPark.
    [term.csv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]
2016-06-26 Regenerate pdf schematic for terminator board.
2016-06-26 Keep copper 20mil away from board edge. Minor clean ups. Upload to OSHPark.
    [clock-B.Cu.gbr, clock-B.Mask.gbr, clock-B.SilkS.gbr, clock-Edge.Cuts.gbr, clock-F.Cu.gbr, clock-F.Mask.gbr, clock-F.SilkS.gbr, clock.drl]
2016-08-09 Preliminary changes from lab bring up. Properly connect ref2 on PCA9306. Duplicate +5V power good to drive +3.3V converter. Change gain structure on OCXO control voltage drive. Add FET control to dis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
    [clock.sch, gps.sch, microzed.sch, ocxo.sch, power.sch, rtctemp.sch]
2016-08-13 Add a hand soldering footprint for the SOD-323 package. Adjust the hand soldering footprint for the SOT-23 package.
2016-08-13 Clean up DRC warnings and errors. Connect the RTC 32KHz clock to a FPGA clock pin.
    [clock.sch, gps.sch, microzed.sch, ocxo.sch, power.sch, rtctemp.sch]
2016-09-04 Change size of edge fingers for board to board connection.
2016-09-04 Remove termination resistors on clock line.
    [disp.kicad_pcb, disp.sch]
2016-09-04 Smaller pad for hand soldering 0805 and 1206 packages.
2016-09-04 Change footprints for 0805 and 1206 packages.
    [disp.kicad_pcb, disp.sch]
2016-09-04 Generate output files for display board. Minor clean up of silkscreen and stitching vias.
    [disp-B.Cu.gbr, disp-B.Mask.gbr, disp-B.SilkS.gbr, disp-B_Cu.gbr, disp-B_Mask.gbr, disp-B_SilkS.gbr, disp-Edge.Cuts.gbr, disp-Edge_Cuts.gbr]
2016-09-04 Update 3D model for 7-segment LED display.
2016-09-12 Move U1 reference designator. Upload to OSHPark.
    [disp-B.Cu.gbr, disp-B.Mask.gbr, disp-B.SilkS.gbr, disp-Edge.Cuts.gbr, disp-F.Cu.gbr, disp-F.Mask.gbr, disp-F.SilkS.gbr, disp.drl]
2017-01-29 Start next revision of the main board. Power sequencing and control changes.
    [clock.sch, gps.sch, microzed.sch, ocxo.sch, power.sch, rtctemp.sch]
2017-01-29 Make pad 0.2mm larger for hand soldering 0805 capacitor.
2017-01-29 Checkpoint layout. Update hand soldering footprints for 0805 parts.
    [clock.kicad_pcb, clock.sch, gps.sch, microzed.sch, ocxo.sch, power.sch, rtctemp.sch]
2017-01-29 Hand soldering version of SOT-23-5. Pads 0.2mm longer.
2017-01-29 Checkpoint clock layout.
    [clock.kicad_pcb]
2017-01-29 Add 3D model for the cx210 cover. Add silk outline for the 1x9 connector on Adafruit's GPS module.
2017-01-30 Add 3D model for SOD-323 diode.
2017-01-30 Checkpoint layout. Change SOT-23-5 to hand soldering version.
    [clock.kicad_pcb, gps.sch, microzed.sch, ocxo.sch]
2017-02-05 0805 LED hand soldering footprint. Red and green 3D model for LED.
2017-02-05 New version of the termination/connector board. Add LED indicators for status and power.
    [term.kicad_pcb, term.sch]
2017-02-05 Adjust the location of the corner mounting holes.
    [clock.kicad_pcb]
2017-02-06 Add power indication LEDs.
    [clock.kicad_pcb, gps.sch, ocxo.sch, power.sch, term.sch]
2017-02-06 Remove sheet to sheet power interconnect because power symbols are global.
    [clock.kicad_pcb, clock.sch, gps.sch, microzed.sch, ocxo.sch, power.sch, rtctemp.sch]
2017-02-07 Move power indicator LEDs. Clean up test points and silkscreen. Move the gate of Q302 to the other side of R301.
    [clock.kicad_pcb, clock.sch, gps.sch, microzed.sch, power.sch, rtctemp.sch]
2017-02-10 Connect temperature sensor interrupt to FPGA.
    [clock.kicad_pcb, clock.sch, microzed.sch, rtctemp.sch]
2017-02-13 Adjust courtyard for diode footprint.
2017-02-13 Clean up some of the trace routing. Update gerber files.
    [clock.csv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]
2017-02-23 Improve clearance around mounting hole.
    [clock-B.Cu.gbr, clock-B.Mask.gbr, clock-B.SilkS.gbr, clock-Edge.Cuts.gbr, clock-F.Cu.gbr, clock-F.Mask.gbr, clock-F.SilkS.gbr, clock.drl]
2017-02-26 Add a VAA power symbol.
2017-02-26 Add missing sheet title to clock schematic. Generate pdf schematic for clock.
    [microzed.sch]
2017-02-26 Termination board: Use power symbols from local library. Generate gerbers. Generate pdf schematic. Generate BOM.
    [term.csv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]
2017-04-15 Make schematic for the display board more readable.
    [disp.kicad_pcb, disp.sch]
2017-04-16 Regenerate the pdf file of the display board schematic.
2017-06-20 Separate RTC interrupt to allow for different IO register clock domain.
    [clock.csv, clock.kicad_pcb, clock.sch, gps.sch, microzed.sch]
2017-06-24 Add DNP to unused resistors on the termination board. Minor clean up of clock board.
    [clock.kicad_pcb, term.csv, term.kicad_pcb, term.sch]
2017-08-16 Label more test points.
    [clock.kicad_pcb]
2017-08-16 Change placement of fan tachometer input components.
    [clock.kicad_pcb]
2017-11-29 Set thermal relief antipad clearance to 15 mil.
    [clock.kicad_pcb, term.kicad_pcb]
2017-11-29 Generate gerbers for termination board v1.1.0. Upload to OSHPark.
    [term-B.Cu.gbr, term-B.Mask.gbr, term-B.SilkS.gbr, term-Edge.Cuts.gbr, term-F.Cu.gbr, term-F.Mask.gbr, term-F.SilkS.gbr, term.drl]
2017-11-29 Generate gerbers for clock board v1.1.0. Upload to OSHPark.
    [clock-B.Cu.gbr, clock-B.Mask.gbr, clock-B.SilkS.gbr, clock-Edge.Cuts.gbr, clock-F.Cu.gbr, clock-F.Mask.gbr, clock-F.SilkS.gbr, clock.drl]
2017-11-29 Regenerate pdf schematic for clock and term boards.
2018-01-21 Swap position of reference designators R301 and R302.
    [clock.kicad_pcb]
2018-01-21 Change schematic values to "as built". Regenerate pdf schematic.
    [clock.csv, clock.kicad_pcb, disp.csv, ocxo.sch, rtctemp.sch]
2018-04-18 Footprint and 3D model of panel mount rj45, usb-a and usb-b connectors.
2018-04-29 Adjust pad size to increase clearances. Add a PTC symbol to the schematic library.
2018-04-29 RJ45 Breakout board.
    [rj45brkout-B.Cu.gbr, rj45brkout-B.Mask.gbr, rj45brkout-B.SilkS.gbr, rj45brkout-Edge.Cuts.gbr, rj45brkout-F.Cu.gbr, rj45brkout-F.Mask.gbr, rj45brkout-F.SilkS.gbr, rj45brkout-In1.Cu.gbr]
2018-04-29 USB-A Breakout board.
    [usbabrkout-B.Cu.gbr, usbabrkout-B.Mask.gbr, usbabrkout-B.SilkS.gbr, usbabrkout-Edge.Cuts.gbr, usbabrkout-F.Cu.gbr, usbabrkout-F.Mask.gbr, usbabrkout-F.SilkS.gbr, usbabrkout-In1.Cu.gbr]
2018-04-29 USB-B Breakout board.
    [usbbbrkout-B.Cu.gbr, usbbbrkout-B.Mask.gbr, usbbbrkout-B.SilkS.gbr, usbbbrkout-Edge.Cuts.gbr, usbbbrkout-F.Cu.gbr, usbbbrkout-F.Mask.gbr, usbbbrkout-F.SilkS.gbr, usbbbrkout-In1.Cu.gbr]
2018-04-29 Footprints for connecting a wire.
2018-05-04 Use 4.0.7 library for local footprint 3D models. Copy rescued symbols into local library.
2018-05-04 Switch designs to the 4.0.7 symbol and footprint library.
    [clock.kicad_pcb, disp.kicad_pcb, term.kicad_pcb, usbabrkout.kicad_pcb, usbabrkout.sch, usbbbrkout.sch]
2018-05-05 1206 Resistor hand soldering footprint.
2018-05-05 Cleanup update to breakout boards. Upload to OSHpark.
    [rj45brkout-B.Cu.gbr, rj45brkout-B.Mask.gbr, rj45brkout-B.SilkS.gbr, rj45brkout-Edge.Cuts.gbr, rj45brkout-F.Cu.gbr, rj45brkout-F.Mask.gbr, rj45brkout-F.SilkS.gbr, rj45brkout-In1.Cu.gbr]
2018-05-10 Fix path to 3D model for SSOP24.
    [disp.kicad_pcb]
2018-05-10 Increase clearances of copper pour. Upload to OSHpark.
    [usbabrkout-B.Cu.gbr, usbabrkout-B.Mask.gbr, usbabrkout-B.SilkS.gbr, usbabrkout-Edge.Cuts.gbr, usbabrkout-F.Cu.gbr, usbabrkout-F.Mask.gbr, usbabrkout-F.SilkS.gbr, usbabrkout-In1.Cu.gbr]
2018-05-12 Step models for the local footprints.
2018-05-17 Adjust clearances of ground and vcc pours.
    [rj45brkout.kicad_pcb, usbbbrkout.kicad_pcb, usbbbrkout.sch]
2018-06-27 Move trace on rj45 break out.
    [rj45brkout.kicad_pcb]
2018-06-27 Regenerate gerbers for USB-B and RJ45 breakout board. Upload to OSHPark.
    [rj45brkout-B.Cu.gbr, rj45brkout-B.Mask.gbr, rj45brkout-B.SilkS.gbr, rj45brkout-Edge.Cuts.gbr, rj45brkout-F.Cu.gbr, rj45brkout-F.Mask.gbr, rj45brkout-F.SilkS.gbr, rj45brkout-In1.Cu.gbr]
2018-06-27 Change pin 1 pad to a square.
2019-12-06 Start new display board 8x 16-segment LED display.
    [8x16seg-B_Cu.gbr, 8x16seg-B_Mask.gbr, 8x16seg-B_SilkS.gbr, 8x16seg-Edge_Cuts.gbr, 8x16seg-F_Cu.gbr, 8x16seg-F_Mask.gbr, 8x16seg-F_SilkS.gbr, 8x16seg-In1_Cu.gbr]
2019-12-06 3D model for 16seg Kingbright PSA08-11SRWA LED display.
2019-12-06 Update 3D model path of local modules for kicad 5.x.
2019-12-06 Update LED module footprint to point to the 3D model.
    [8x16seg.kicad_pcb]
2019-12-06 Minor untested updates. Ground the NC pins on the RTC.
    [clock-B.Cu.gbr, clock-B.Mask.gbr, clock-B.SilkS.gbr, clock-Edge.Cuts.gbr, clock-F.Cu.gbr, clock-F.Mask.gbr, clock-F.SilkS.gbr, clock.drl]
2019-12-08 Update term board to kicad 5.1. Regenerate output files.
    [term-B.Cu.gbr, term-B.SilkS.gbr, term-B_Cu.gbr, term-B_Mask.gbr, term-B_SilkS.gbr, term-Edge_Cuts.gbr, term-F.Cu.gbr, term-F.SilkS.gbr]
2019-12-08 Update rj45 break out board to kicad 5.1. Regenerate output files.
    [rj45brkout-B.SilkS.gbr, rj45brkout-B_Cu.gbr, rj45brkout-B_Mask.gbr, rj45brkout-B_SilkS.gbr, rj45brkout-Edge_Cuts.gbr, rj45brkout-F.SilkS.gbr, rj45brkout-F_Cu.gbr, rj45brkout-F_Mask.gbr]
2019-12-08 Update USB-A breakout board to kicad 5.1. Regenerate output files.
    [usbabrkout-B.SilkS.gbr, usbabrkout-B_Cu.gbr, usbabrkout-B_Mask.gbr, usbabrkout-B_SilkS.gbr, usbabrkout-Edge_Cuts.gbr, usbabrkout-F.SilkS.gbr, usbabrkout-F_Cu.gbr, usbabrkout-F_Mask.gbr]
2019-12-08 Update USB-B breakout board to kicad 5.1. Regenerate output files.
    [usbbbrkout-B.SilkS.gbr, usbbbrkout-B_Cu.gbr, usbbbrkout-B_Mask.gbr, usbbbrkout-B_SilkS.gbr, usbbbrkout-Edge_Cuts.gbr, usbbbrkout-F.SilkS.gbr, usbbbrkout-F_Cu.gbr, usbbbrkout-F_Mask.gbr]
2019-12-08 Update display board to kicad 5.1. Regenerate output files.
    [disp-B.Cu.gbr, disp-B_Cu.gbr, disp-B_Mask.gbr, disp-B_SilkS.gbr, disp-Edge_Cuts.gbr, disp-F.Cu.gbr, disp-F.SilkS.gbr, disp-F_Cu.gbr]
2019-12-09 Fix display board to point to 5.1 symbol libraries.
    [disp.sch]
2019-12-09 Fix terminator board to point to 5.1 symbol libraries.
    [term.csv, term.kicad_pcb, term.sch]
2019-12-09 Fix rj45 break out board to point to 5.1 symbol libraries. Fix USB-A break out board to point to 5.1 symbol libraries. Fix USB-B break out board to point to 5.1 symbol libraries.
    [rj45brkout.sch, usbabrkout.sch, usbbbrkout.sch]
2019-12-09 Update clock board to kicad 5.1. Regenerate output files.
    [clock-B.Cu.gbr, clock-B.SilkS.gbr, clock-B_Cu.gbr, clock-B_Mask.gbr, clock-B_SilkS.gbr, clock-Edge_Cuts.gbr, clock-F.Cu.gbr, clock-F.SilkS.gbr]
2019-12-10 Bump clock version to v1.1.2 (Ground NC pins on RTC). Fix 3D model paths to use kicad 5.1 libraries. Regenerate output files.
    [clock.csv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]
2019-12-12 Center the 4-pin DC-DC converter SIP package on pin 1.
2019-12-17 Add NC to unused pins.
    [8x16seg.csv, 8x16seg.kicad_pcb, 8x16seg.sch]
2019-12-29 Fill in the footprint descriptions.
2019-12-29 Cherry pick changes to the solder mask for the MELF diode.
2020-01-08 Add a current source chip to the library. Add F.Fab layer drawing to footprints.
2020-01-13 Change pin number preference on the PSSI2021SAY symbol.
2020-04-05 Move the symbol and footprint library files to the kicad-lib repository and delete them from this one.
2021-12-19 Regenerate gerbers for 8x16-segment display board.
    [8x16seg-B_Cu.gbr, 8x16seg-B_Mask.gbr, 8x16seg-B_SilkS.gbr, 8x16seg-Edge_Cuts.gbr, 8x16seg-F_Cu.gbr, 8x16seg-F_Mask.gbr, 8x16seg-F_SilkS.gbr, 8x16seg-In1_Cu.gbr]
2021-12-19 Update email address, regenerate gerber and plots. Change the sheet size of the clock power schematic page to A4.
    [8x16seg-B_Cu.gbr, 8x16seg-B_Mask.gbr, 8x16seg-B_SilkS.gbr, 8x16seg-Edge_Cuts.gbr, 8x16seg-F_Cu.gbr, 8x16seg-F_Mask.gbr, 8x16seg-F_SilkS.gbr, 8x16seg-In1_Cu.gbr]
2025-01-21 Update usbbbrkout design to KiCad 8.
    [usbbbrkout-B_Cu.gbr, usbbbrkout-B_Mask.gbr, usbbbrkout-B_SilkS.gbr, usbbbrkout-B_Silkscreen.gbr, usbbbrkout-Edge_Cuts.gbr, usbbbrkout-F_Cu.gbr, usbbbrkout-F_Mask.gbr, usbbbrkout-F_SilkS.gbr]
2025-01-21 Update usbabrkout design to KiCad 8.
    [usbabrkout-B_Cu.gbr, usbabrkout-B_Mask.gbr, usbabrkout-B_SilkS.gbr, usbabrkout-B_Silkscreen.gbr, usbabrkout-Edge_Cuts.gbr, usbabrkout-F_Cu.gbr, usbabrkout-F_Mask.gbr, usbabrkout-F_SilkS.gbr]
2025-01-21 Update rj45brkout design to KiCad 8.
    [rj45brkout-B_Cu.gbr, rj45brkout-B_Mask.gbr, rj45brkout-B_SilkS.gbr, rj45brkout-B_Silkscreen.gbr, rj45brkout-Edge_Cuts.gbr, rj45brkout-F_Cu.gbr, rj45brkout-F_Mask.gbr, rj45brkout-F_SilkS.gbr]
2025-01-22 Update term design to KiCad 8.
    [term-B_Cu.gbr, term-B_Mask.gbr, term-B_SilkS.gbr, term-B_Silkscreen.gbr, term-Edge_Cuts.gbr, term-F_Cu.gbr, term-F_Mask.gbr, term-F_SilkS.gbr]
2025-01-25 Update 2x7seg design to KiCad 8.
    [disp-B_Cu.gbr, disp-B_Mask.gbr, disp-B_SilkS.gbr, disp-B_Silkscreen.gbr, disp-Edge_Cuts.gbr, disp-F_Cu.gbr, disp-F_Mask.gbr, disp-F_SilkS.gbr]
2025-01-25 Update 8x16seg design to KiCad 8.
    [8x16seg-B_Cu.gbr, 8x16seg-B_Mask.gbr, 8x16seg-B_SilkS.gbr, 8x16seg-B_Silkscreen.gbr, 8x16seg-Edge_Cuts.gbr, 8x16seg-F_Cu.gbr, 8x16seg-F_Mask.gbr, 8x16seg-F_SilkS.gbr]
2025-01-25 Update clock design to KiCad 8.
    [clock-B_Cu.gbr, clock-B_Mask.gbr, clock-B_SilkS.gbr, clock-B_Silkscreen.gbr, clock-Edge_Cuts.gbr, clock-F_Cu.gbr, clock-F_Mask.gbr, clock-F_SilkS.gbr]
2025-01-25 Update symbols in 2x7seg design.
    [disp.kicad_sch]
2025-01-25 Make some net names consistent with hierarchy names. Clean up some silkscreen DRCs.
    [clock-B_Cu.gbr, clock-B_Mask.gbr, clock-B_Silkscreen.gbr, clock-Edge_Cuts.gbr, clock-F_Cu.gbr, clock-F_Mask.gbr, clock-F_Silkscreen.gbr, clock.drl]
2025-01-27 Update symbols in 8x16seg, usbabrkout, and usbbbrkout schematics.
    [8x16seg.kicad_sch, usbabrkout.kicad_sch, usbbbrkout.kicad_sch]
2025-01-27 Bump version string of 2x7seg to v1.3.0.
    [disp-B_Cu.gbr, disp-B_Mask.gbr, disp-B_Silkscreen.gbr, disp-Edge_Cuts.gbr, disp-F_Cu.gbr, disp-F_Mask.gbr, disp-F_Silkscreen.gbr, disp.drl]
2025-01-27 Bump version string of 8x16seg to v1.1.0.
    [8x16seg-B_Cu.gbr, 8x16seg-B_Mask.gbr, 8x16seg-B_Silkscreen.gbr, 8x16seg-Edge_Cuts.gbr, 8x16seg-F_Cu.gbr, 8x16seg-F_Mask.gbr, 8x16seg-F_Silkscreen.gbr, 8x16seg-In1_Cu.gbr]
2025-01-27 Bump version string of clock to v1.2.0.
    [clock-B_Cu.gbr, clock-B_Mask.gbr, clock-B_Silkscreen.gbr, clock-Edge_Cuts.gbr, clock-F_Cu.gbr, clock-F_Mask.gbr, clock-F_Silkscreen.gbr, clock.drl]
2025-01-27 Bump version string of rj45brkout to v1.1.0.
    [rj45brkout-B_Cu.gbr, rj45brkout-B_Mask.gbr, rj45brkout-B_Silkscreen.gbr, rj45brkout-Edge_Cuts.gbr, rj45brkout-F_Cu.gbr, rj45brkout-F_Mask.gbr, rj45brkout-F_Silkscreen.gbr, rj45brkout-In1_Cu.gbr]
2025-01-27 Bump version string of term to v1.2.0.
    [term-B_Cu.gbr, term-B_Mask.gbr, term-B_Silkscreen.gbr, term-Edge_Cuts.gbr, term-F_Cu.gbr, term-F_Mask.gbr, term-F_Silkscreen.gbr, term.drl]
2025-01-27 Bump version string of usbabrkout to v1.1.0.
    [usbabrkout-B_Cu.gbr, usbabrkout-B_Mask.gbr, usbabrkout-B_Silkscreen.gbr, usbabrkout-Edge_Cuts.gbr, usbabrkout-F_Cu.gbr, usbabrkout-F_Mask.gbr, usbabrkout-F_Silkscreen.gbr, usbabrkout-In1_Cu.gbr]
2025-01-27 Bump version string of usbbbrkout to v1.1.0.
    [usbbbrkout-B_Cu.gbr, usbbbrkout-B_Mask.gbr, usbbbrkout-B_Silkscreen.gbr, usbbbrkout-Edge_Cuts.gbr, usbbbrkout-F_Cu.gbr, usbbbrkout-F_Mask.gbr, usbbbrkout-F_Silkscreen.gbr, usbbbrkout-In1_Cu.gbr]
2025-01-28 Change sheet size of clock PCB to A4.
    [clock-B_Cu.gbr, clock-B_Mask.gbr, clock-B_Silkscreen.gbr, clock-Edge_Cuts.gbr, clock-F_Cu.gbr, clock-F_Mask.gbr, clock-F_Silkscreen.gbr, clock.drl]
2025-02-12 Set the PCB grid origin so that KiCadStepUp loads the board at the FreeCAD origin.
    [disp.kicad_pcb, rj45brkout.kicad_pcb, term.kicad_pcb, usbabrkout.kicad_pcb, usbbbrkout.kicad_pcb]
